ronand68/Ronand_Peralta_Electiva_2026_C1/tarea 1/DOC - Plantilla SRS ERS Norma IEEE-830 STD Wallys.odt

Especificación de requisitos de software

Proyecto: NIZAO

Revisión 1.0

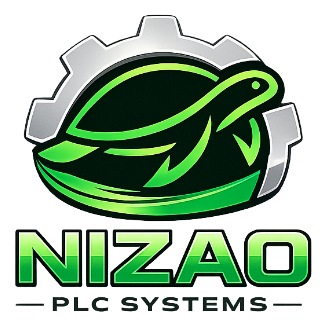
[picture p1: figure]

| | 01/2026

Instrucciones para el uso de este formato

Este formato es una plantilla tipo para documentos de requisitos del software.

Está basado y es conforme con el estándar IEEE Std 830-1998.

Las secciones que no se consideren aplicables al sistema descrito podrán de forma justificada indicarse como no aplicables (NA).

Notas:

Los textos en color azul son indicaciones que deben eliminarse y, en su caso, sustituirse por los contenidos descritos en cada apartado.

Los textos entre corchetes del tipo “[Inserte aquí el texto]” permiten la inclusión directa de texto con el color y estilo adecuado a la sección, al pulsar sobre ellos con el puntero del ratón.

Los títulos y subtítulos de cada apartado están definidos como estilos de MS Word, de forma que su numeración consecutiva se genera automáticamente según se trate de estilos “Titulo1, Titulo2 y Titulo3”.

La sangría de los textos dentro de cada apartado se genera automáticamente al pulsar Intro al final de la línea de título. (Estilos Normal indentado1, Normal indentado 2 y Normal indentado 3).

El índice del documento es una tabla de contenido que MS Word actualiza tomando como criterio los títulos del documento.

Una vez terminada su redacción debe indicarse a Word que actualice todo su contenido para reflejar el contenido definitivo.

De la plantilla de formato del documento © & Coloriuris http://www.qualitatis.org

# Ficha del documento

Fecha | Revisión | Autor | Verificado dep. calidad.
21/01/2026 | 1.0 | Wally Josep Hernandez Baez – Departamento de Proyectos | Pendiente

Documento validado por las partes en fecha: [Fecha]

Por el cliente | Por la empresa suministradora
Pendiente | Pendiente
Fdo. D./ Dña [Nombre] | Fdo. D./Dña [Nombre]

# Contenido

# Introducción

[Inserte aquí el texto]

## Propósito

Este documento define las especificaciones técnicas y los requisitos funcionales para el desarrollo del sistema [Nombre del Dron/Proyecto]. El objetivo es proporcionar una guía detallada para la integración de hardware, desarrollo de firmware y software de control de un sistema aéreo no tripulado (UAS) especializado en la inspección de infraestructuras críticas y monitoreo ambiental en entornos industriales.

## Alcance

[Inserte aquí el texto]

Capacidades Operativas

    - El desarrollo abarcará el diseño, integración y validación de las siguientes capacidades:
- Vuelo Multimodal: Implementación de modos de vuelo manual (asistido por sensores) y autónomo (mediante waypoints y misiones programadas vía Ground Control Station).
- Inspección Termográfica: Captura y transmisión en tiempo real de datos radiométricos para la identificación de anomalías térmicas en rangos de $[ -20°C, 550°C ]$.
- Monitoreo de Gases: Integración de un sistema de muestreo atmosférico capaz de detectar concentraciones de gases específicos (ej. $CH_4$, $CO$, $CO_2$) con georreferenciación de cada lectura.
- Navegación en Entornos Complejos: Sistema de evasión de obstáculos basado en sensores (ToF o Visión Computarizada) para garantizar la integridad en proximidad a estructuras metálicas.

### Desarrollo de Software y Control

- Interfaz de Control (GCS): Desarrollo o adaptación de una estación terrestre que permita la visualización simultánea de telemetría, video RGB/Térmico y niveles de gas.
- Algoritmos de Autonomía: Implementación de rutas de inspección optimizadas y protocolos de seguridad (RTL - Return to Launch) ante pérdida de enlace o batería crítica.
- Gestión de Datos: Creación de un log unificado que sincronice la posición GPS con las lecturas térmicas y químicas para su posterior análisis (Post-procesamiento).

## Personal involucrado

Nombre | Cristian Alejandro Candelario González[Inserte aquí el texto] | Wesley Antoine Rosario Pineda | Dayanna Yolanda Castillo Zacarias | José Alberto Canario Torres | Jhanquelis Silverio
Rol | = | = | = | = | =
Categoría profesional | Tecnico[Inserte aquí el texto] | Tecnico | Tecnico | Tecnico | Tecnico
Responsabilidades | [Inserte aquí el texto]
Información de contacto | [Inserte aquí el texto]
Aprobación | [Inserte aquí el texto]

## Definiciones, acrónimos y abreviaturas

### Definiciones Generales

- Carga Útil (Payload): Todo elemento transportado por el dron que no es necesario para el vuelo en sí, en este caso, el conjunto de cámaras térmicas y sensores de gas.
- GCS (Ground Control Station): Centro de mando terrestre (software y hardware) desde el cual se monitorea y controla el dron.
- Geofencing: Perímetro virtual definido por coordenadas GPS que limita el área de vuelo permitida por seguridad.
- Misión de Waypoints: Conjunto de coordenadas preprogramadas que el dron sigue de forma autónoma para completar una ruta de inspección.
- Radiometría: Capacidad de una cámara térmica para medir la temperatura absoluta de cada píxel en una imagen, no solo mostrar contrastes de calor.

[Inserte aquí el texto]

## Referencias

Referencia | Titulo | Ruta | Fecha | Autor
[Ref.] | [Título] | [Ruta] | [Fecha] | [Autor]

Relación completa de todos los documentos relacionados en la especificación de requisitos de software, identificando de cada documento el titulo, referencia (si procede), fecha y organización que lo proporciona.

## Resumen

[Inserte aquí el texto]

- Descripción del contenido del resto del documento
- Explicación de la organización del documento

# Descripción general

## Perspectiva del producto

NIZAO PLC es un PLC didáctico diseñado para prácticas de laboratorio. El producto no se usa como un equipo “aislado”, sino como el controlador central dentro de un puesto de entrenamiento donde los estudiantes cablean, programan y verifican maniobras típicas (arranque/parada, inversión de giro, enclavamientos, temporizaciones, conteos, secuencias y control básico de motores).

### Funcionalidad del producto

[Inserte aquí el texto]

Resumen de las funcionalidades principales que el producto debe realizar, sin entrar en información de detalle.

En ocasiones la información de esta sección puede tomarse de un documento de especificación del sistema de mayor nivel (ej. Requisitos del sistema).

Las funcionalidades deben estar organizadas de manera que el cliente o cualquier interlocutor pueda entenderlo perfectamente. Para ello se pueden utilizar métodos textuales o gráficos.

## Características de los usuarios

Tipo de usuario | [Inserte aquí el texto]
Formación | [Inserte aquí el texto]
Habilidades | [Inserte aquí el texto]
Actividades | [Inserte aquí el texto]

Descripción de los usuarios del producto, incluyendo nivel educacional, experiencia y experiencia técnica.

## Restricciones

[Inserte aquí el texto]

Descripción de aquellas limitaciones a tener en cuenta a la hora de diseñar y desarrollar el sistema, tales como el empleo de determinadas metodologías de desarrollo, lenguajes de programación, normas particulares, restricciones de hardware, de sistema operativo etc.

## Suposiciones y dependencias

[Inserte aquí el texto]

Descripción de aquellos factores que, si cambian, pueden afectar a los requisitos. Por ejemplo una asunción puede ser que determinado sistema operativo está disponible para el hardware requerido. De hecho, si el sistema operativo no estuviera disponible, la SRS debería modificarse.

## Evolución previsible del sistema

[Inserte aquí el texto]

Identificación de futuras mejoras al sistema, que podrán analizarse e implementarse en un futuro.

# Requisitos específicos

Esta es la sección más extensa y más importante del documento.

Debe contener una lista detallada y completa de los requisitos que debe cumplir el sistema a desarrollar. El nivel de detalle de los requisitos debe ser el suficiente para que el equipo de desarrollo pueda diseñar un sistema que satisfaga los requisitos y los encargados de las pruebas puedan determinar si éstos se satisfacen.

Los requisitos se dispondrán en forma de listas numeradas para su identificación, seguimiento, trazabilidad y validación (ej. RF 10, RF 10.1, RF 10.2,...).

Para cada requisito debe completarse la siguiente tabla:

Número de requisito | [Inserte aquí el texto]
Nombre de requisito | [Inserte aquí el texto]
Tipo | Requisito | Restricción
Fuente del requisito | [Inserte aquí el texto]
Prioridad del requisito | Alta/Esencial | Media/Deseado | Baja/ Opcional

y realizar la descripción del requisito

La distribución de los párrafos que forman este punto puede diferir del propuesto en esta plantilla, si las características del sistema aconsejan otra distribución para ofrecer mayor claridad en la exposición.

## Requisitos comunes de los interfaces

[Inserte aquí el texto]

Descripción detallada de todas las entradas y salidas del sistema de software.

### Interfaces de usuario

[Inserte aquí el texto]

Describir los requisitos del interfaz de usuario para el producto. Esto puede estar en la forma de descripciones del texto o pantallas del interfaz. Por ejemplo posiblemente el cliente ha especificado el estilo y los colores del producto. Describa exacto cómo el producto aparecerá a su usuario previsto.

### Interfaces de hardware

[Inserte aquí el texto]

Especificar las características lógicas para cada interfaz entre el producto y los componentes de hardware del sistema. Se incluirán características de configuración.

### Interfaces de software

[Inserte aquí el texto]

Indicar si hay que integrar el producto con otros productos de software.

Para cada producto de software debe especificarse lo siguiente:

- Descripción del producto software utilizado
- Propósito del interfaz
- Definición del interfaz: contiendo y formato

### Interfaces de comunicación

[Inserte aquí el texto]

Describir los requisitos del interfaces de comunicación si hay comunicaciones con otros sistemas y cuales son las protocolos de comunicación.

## Requisitos funcionales

[Inserte aquí el texto]

Definición de acciones fundamentales que debe realizar el software al recibir información, procesarla y producir resultados.

En ellas se incluye:

- Comprobación de validez de las entradas
- Secuencia exacta de operaciones
- Respuesta a situaciones anormales (desbordamientos, comunicaciones, recuperación de errores)
- Parámetros
- Generación de salidas
- Relaciones entre entradas y salidas (secuencias de entradas y salidas, formulas para la conversión de información)
- Especificación de los requisitos lógicos para la información que será almacenada en base de datos (tipo de información, requerido)

Las requisitos funcionales pueden ser divididos en sub-secciones.

### Requisito funcional 1

### Requisito funcional 2

### Requisito funcional 3

### Requisito funcional n

## Requisitos no funcionales

### Requisitos de rendimiento

[Inserte aquí el texto]

Especificación de los requisitos relacionados con la carga que se espera tenga que soportar el sistema. Por ejemplo, el número de terminales, el número esperado de usuarios simultáneamente conectados, número de transacciones por segundo que deberá soportar el sistema, etc.

Todos estos requisitos deben ser mesurables. Por ejemplo, indicando “el 95% de las transacciones deben realizarse en menos de 1 segundo”, en lugar de “los operadores no deben esperar a que se complete la transacción”.

### Seguridad

[Inserte aquí el texto]

Especificación de elementos que protegerán al software de accesos, usos y sabotajes maliciosos, así como de modificaciones o destrucciones maliciosas o accidentales. Los requisitos pueden especificar:

- Empleo de técnicas criptográficas.
- Registro de ficheros con “logs” de actividad.
- Asignación de determinadas funcionalidades a determinados módulos.
- Restricciones de comunicación entre determinados módulos.
- Comprobaciones de integridad de información crítica.

### Fiabilidad

[Inserte aquí el texto]

Especificación de los factores de fiabilidad necesaria del sistema. Esto se expresa generalmente como el tiempo entre los incidentes permisibles, o el total de incidentes permisible.

### Disponibilidad

[Inserte aquí el texto]

Especificación de los factores de disponibilidad final exigidos al sistema. Normalmente expresados en % de tiempo en los que el software tiene que mostrar disponibilidad.

### Mantenibilidad

[Inserte aquí el texto]

Identificación del tipo de mantenimiento necesario del sistema.

Especificación de quien debe realizar las tareas de mantenimiento, por ejemplo usuarios, o un desarrollador.

Especificación de cuando debe realizarse las tareas de mantenimiento. Por ejemplo, generación de estadísticas de acceso semanales y mensuales.

### Portabilidad

[Inserte aquí el texto]

Especificación de atributos que debe presentar el software para facilitar su traslado a otras plataformas u entornos. Pueden incluirse:

- Porcentaje de componentes dependientes del servidor.
- Porcentaje de código dependiente del servidor.
- Uso de un determinado lenguaje por su portabilidad.
- Uso de un determinado compilador o plataforma de desarrollo.
- Uso de un determinado sistema operativo.

## Otros requisitos

[Inserte aquí el texto]

Cualquier otro requisito que no encaje en ninguna de las secciones anteriores.

Por ejemplo:

Requisitos culturales y políticos

Requisitos Legales

# Apéndices

[Inserte aquí el texto]

Pueden contener todo tipo de información relevante para la SRS pero que, propiamente, no forme parte de la SRS.

Modelo de ingeniería [Nombre documento] 0.3 Pág. 3

Descripción de requisitos del sofware

PLC FOR UNI Especificación de requisitos de software Rev. [99.99] Pág. 5

NIZAO Especificación de requisitos de software Rev. [99.99] Pág. 5
