ronand68/Ronand_Peralta_Electiva_2026_C1/tarea 1/ERS_NIZAO_PLC_IEEE830.docx

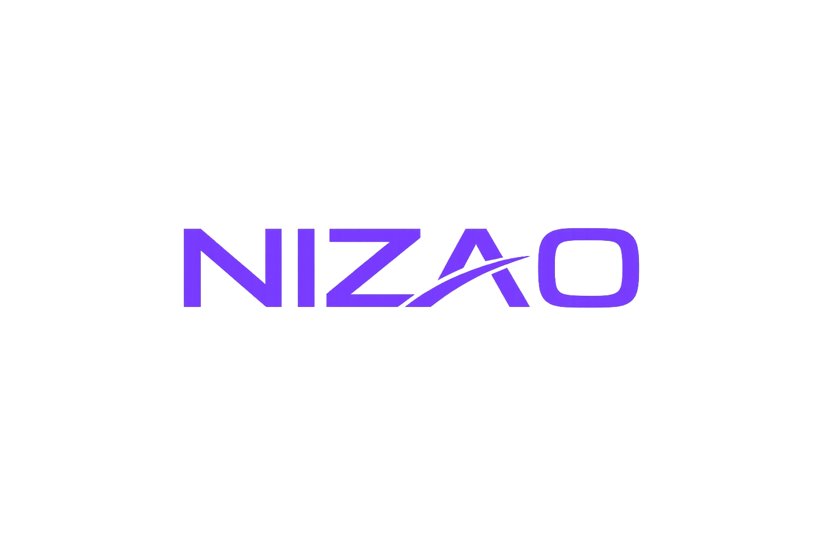
[picture p2: figure]

Especificación de requisitos de software

Proyecto: NIZAO PLC

Revisión 1.0

| | 04/2026

Instrucciones para el uso de este formato

Este formato es una plantilla tipo para documentos de requisitos del software.

Está basado y es conforme con el estándar IEEE Std 830-1998.

Las secciones que no se consideren aplicables al sistema descrito podrán de forma justificada indicarse como no aplicables (NA).

Notas:

Los textos en color azul son indicaciones que deben eliminarse y, en su caso, sustituirse por los contenidos descritos en cada apartado.

Los textos entre corchetes del tipo “[Inserte aquí el texto]” permiten la inclusión directa de texto con el color y estilo adecuado a la sección, al pulsar sobre ellos con el puntero del ratón.

Los títulos y subtítulos de cada apartado están definidos como estilos de MS Word, de forma que su numeración consecutiva se genera automáticamente según se trate de estilos “Titulo1, Titulo2 y Titulo3”.

La sangría de los textos dentro de cada apartado se genera automáticamente al pulsar Intro al final de la línea de título. (Estilos Normal indentado1, Normal indentado 2 y Normal indentado 3).

El índice del documento es una tabla de contenido que MS Word actualiza tomando como criterio los títulos del documento.

Una vez terminada su redacción debe indicarse a Word que actualice todo su contenido para reflejar el contenido definitivo.

De la plantilla de formato del documento © & Coloriuris http://www.qualitatis.org

# Ficha del documento

Fecha | Revisión | Autor | Verificado dep. calidad.
23/04/2026 | 1.0 | Ronand Peralta – Proyecto NIZAO PLC | Pendiente

Documento validado por las partes en fecha: [Fecha]

Por el cliente | Por la empresa suministradora
Pendiente | Pendiente
Fdo. D./Dña. Representante del cliente | Fdo. D./Dña. Representante del equipo NIZAO

# Contenido

# 2 Introducción

La presente Especificación de Requisitos de Software (ERS) describe las necesidades funcionales y no funcionales del proyecto NIZAO PLC, un controlador lógico programable didáctico e industrial basado en el microcontrolador ESP32-S3-WROOM-1. El documento se elabora con el fin de conservar la estructura formal de la plantilla IEEE 830 y servir como guía de desarrollo, integración y validación del sistema.

## 2.1 Propósito

Este documento define las especificaciones técnicas y los requisitos funcionales del sistema NIZAO PLC. Su propósito es establecer una base clara para el diseño de hardware y firmware, la implementación de la HMI, la integración de comunicaciones industriales y la posterior verificación del comportamiento del controlador.

## 2.2 Alcance

El alcance de esta ERS comprende el firmware principal del PLC, la interfaz HMI local, los drivers de entradas y salidas, la conectividad industrial y los servicios de configuración. El sistema está orientado a prácticas de laboratorio, prototipado, validación de arquitectura PLC/HMI y futuras pruebas con PCB propio.

Capacidades Operativas

    - El desarrollo abarcará el diseño, integración y validación de las siguientes capacidades:
- Adquisición de entradas digitales: lectura de señales de campo NPN y PNP con actualización cíclica y representación en HMI.
- Control de salidas digitales: accionamiento de salidas NPN, PNP y de relé con visualización de estado y operación segura.
- Adquisición analógica: lectura de variables a través de ADC externo para soportar señales de proceso y sensórica complementaria.
- Generación analógica: control de salidas 4-20 mA y 0-10 V para instrumentación y actuadores compatibles.

### 2.2.1 Monitorización de energía: lectura de variables como voltaje, corriente, potencia y frecuencia mediante el lector de energía.

- Interfaz HMI: navegación en pantalla táctil LCD con menús de Inicio, Estados, Control, Configuración, Comunicación, Alarmas, Mantenimiento y Sistema.
- Comunicación industrial: integración de Modbus, MQTT, OpenPLC y 4Diac mediante una arquitectura modular y escalable.
- Configuración y servicio: configuración local y remota por web server, Wi‑Fi, Bluetooth BLE, USB device y almacenamiento en SD.

Trazabilidad y mantenimiento: registro de parámetros, conservación de configuración y posibilidad de ampliación del firmware por componentes.

Nombre | Ronand Peralta | Equipo de firmware NIZAO | Equipo HMI y documentación | Equipo de integración | Control de calidad
Rol | Líder del proyecto | Desarrollo embebido | Diseño de interfaz | Comunicaciones y servicios | Pruebas y documentación
Categoría profesional | Técnico / Estudiante | Técnico | Técnico | Técnico | Técnico
Responsabilidades | Definir requisitos, arquitectura, integración y validación general del PLC NIZAO. | Implementar firmware base, drivers y servicios del sistema. | Definir pantallas, navegación HMI y lineamientos de experiencia de usuario. | Integrar Modbus, MQTT, web config, Wi‑Fi y BLE. | Ejecutar pruebas funcionales y mantener la ERS actualizada.
Información de contacto | Pendiente de completar | Pendiente | Pendiente | Pendiente | Pendiente
Aprobación | Pendiente de aprobación | Pendiente | Pendiente | Pendiente | Pendiente

## 2.4 Definiciones, acrónimos y abreviaturas

### 2.4.1 Definiciones Generales

- PLC (Programmable Logic Controller): equipo programable destinado a la adquisición de señales de entrada, procesamiento lógico y control de salidas en procesos de automatización.
- HMI (Human Machine Interface): interfaz hombre-máquina que permite al usuario visualizar estados, alarmas, parámetros y acciones de control sobre el PLC.
- ESP-IDF: framework oficial de Espressif para el desarrollo de firmware sobre ESP32-S3, utilizado como base del proyecto NIZAO PLC.
- LVGL: librería gráfica utilizada para construir la interfaz visual de la HMI y la navegación de pantallas del sistema.
- Modbus / MQTT / OpenPLC / 4Diac: protocolos y capas de interoperabilidad previstas para comunicación industrial, supervisión y lógica distribuida.

Abreviaturas principales: DI (Digital Input), DO (Digital Output), AI (Analog Input), AO (Analog Output), BLE (Bluetooth Low Energy), HMI (Human Machine Interface), ERS (Especificación de Requisitos de Software).

## 2.5 Referencias

Referencia | Titulo | Ruta | Fecha | Autor
REF-01 | ESP-IDF Programming Guide v6.0 | https://docs.espressif.com/projects/esp-idf/en/v6.0/ | 2026 | Espressif Systems
REF-02 | LVGL Documentation | https://docs.lvgl.io/ | 2026 | LVGL Project
REF-03 | IEEE Std 830-1998 | Especificación de requisitos de software | 1998 | IEEE
REF-04 | Planificación de la Pantalla - Imágenes | Documento interno del proyecto | 2026 | Proyecto NIZAO
REF-05 | plc_firmware.zip | Repositorio base del firmware del PLC NIZAO | 2026 | Proyecto NIZAO

Relación completa de todos los documentos relacionados en la especificación de requisitos de software, identificando de cada documento el titulo, referencia (si procede), fecha y organización que lo proporciona.

## 2.6 Resumen

El documento se organiza en: introducción, descripción general, requisitos específicos y apéndices. Cada sección conserva la estructura de la plantilla y se ha completado con la información correspondiente al proyecto NIZAO PLC.

- Descripción del contenido del resto del documento: la sección 2 resume el producto, la sección 3 establece requisitos verificables y la sección 4 reúne información de apoyo, mapas y anexos.
- Explicación de la organización del documento: la ERS sirve de referencia para el equipo de desarrollo, pruebas e integración, y deberá actualizarse conforme avance el hardware definitivo.

# 3 Descripción general

## 3.1 Perspectiva del producto

## 3.2 NIZAO PLC es un PLC didáctico y de desarrollo diseñado para prácticas de laboratorio, demostración tecnológica y futura validación sobre PCB propio. El producto actúa como controlador central con arquitectura modular, separando BSP, drivers, servicios, comunicaciones, núcleo PLC y HMI.

### 3.2.1 Funcionalidad del producto

El producto debe realizar, de manera resumida, las siguientes funciones: lectura y monitoreo de entradas digitales; control de salidas digitales; lectura de entradas analógicas y energía; generación de salidas analógicas; presentación de estados y alarmas en una HMI táctil; configuración local y remota; comunicación por Modbus y MQTT; y distribución de un snapshot de E/S hacia OpenPLC y 4Diac.

## 3.3 Características de los usuarios

Tipo de usuario | Estudiantes de automatización, docentes, técnicos de laboratorio e integradores.
Formación | Formación técnica en electrónica, mecatrónica, electricidad o automatización industrial.
Habilidades | Cableado básico de E/S, interpretación de estados, configuración de parámetros y uso de interfaces HMI.
Actividades | Configurar el equipo, monitorear variables, ejecutar prácticas, validar señales y realizar pruebas funcionales.

Descripción de los usuarios del producto, incluyendo nivel educacional, experiencia y experiencia técnica.

## 3.4 Restricciones

El sistema debe ejecutarse sobre el microcontrolador ESP32-S3-WROOM-1 y desarrollarse en ESP-IDF. La HMI debe adecuarse a una pantalla compacta de aproximadamente 320 px de ancho. La arquitectura se desarrollará primero en software, debido a que el PCB definitivo aún no se encuentra disponible. El USB deberá usarse en modo dispositivo y la configuración deberá contemplar web server, Wi‑Fi y Bluetooth.

Descripción de aquellas limitaciones a tener en cuenta a la hora de diseñar y desarrollar el sistema, tales como el empleo de determinadas metodologías de desarrollo, lenguajes de programación, normas particulares, restricciones de hardware, de sistema operativo etc.

## 3.5 Suposiciones y dependencias

Se asume la disponibilidad de una pantalla LCD táctil compatible, drivers escalables para los distintos periféricos y la futura definición de los pines finales del PCB. También se asume la continuidad de la arquitectura modular actual y la posibilidad de integrar servicios como Modbus, MQTT, LVGL, TinyUSB y manejo de SD sin rediseñar la base del firmware.

Descripción de aquellos factores que, si cambian, pueden afectar a los requisitos. Por ejemplo una asunción puede ser que determinado sistema operativo está disponible para el hardware requerido. De hecho, si el sistema operativo no estuviera disponible, la SRS debería modificarse.

## 3.6 Evolución previsible del sistema

Como evolución prevista se contemplan: integración del hardware final del PCB; paso de drivers mock/skeleton a drivers reales; ampliación del mapa Modbus; incorporación de registro de datos en SD; actualización OTA; refuerzo de seguridad y autenticación; y madurez del bridge con OpenPLC y 4Diac.

Identificación de futuras mejoras al sistema, que podrán analizarse e implementarse en un futuro.

# 4 Requisitos específicos

Esta es la sección más extensa y más importante del documento.

Debe contener una lista detallada y completa de los requisitos que debe cumplir el sistema a desarrollar. El nivel de detalle de los requisitos debe ser el suficiente para que el equipo de desarrollo pueda diseñar un sistema que satisfaga los requisitos y los encargados de las pruebas puedan determinar si éstos se satisfacen.

Los requisitos se dispondrán en forma de listas numeradas para su identificación, seguimiento, trazabilidad y validación (ej. RF 10, RF 10.1, RF 10.2,...).

Para cada requisito debe completarse la siguiente tabla:

Número de requisito | RF-03
Nombre de requisito | Comunicaciones industriales
Tipo | Requisito | Requisito
Fuente del requisito | Necesidad del proyecto
Prioridad del requisito | Alta/Esencial | Alta/Esencial | Alta/Esencial

y realizar la descripción del requisito

La distribución de los párrafos que forman este punto puede diferir del propuesto en esta plantilla, si las características del sistema aconsejan otra distribución para ofrecer mayor claridad en la exposición.

## 4.1 Requisitos comunes de los interfaces

El sistema de software debe contemplar interfaces para usuario, hardware, software y comunicaciones. Entre sus principales E/S se consideran entradas digitales NPN/PNP, salidas digitales NPN/PNP/relé, entradas analógicas por ADC externo, salidas analógicas 4-20 mA y 0-10 V, lectura de energía, pantalla LCD táctil, USB device, SD, Wi‑Fi, BLE y buses de comunicación industriales.

Descripción detallada de todas las entradas y salidas del sistema de software.

### 4.1.1 Interfaces de usuario

La interfaz de usuario será una HMI con estilo moderno e industrial, menú horizontal compacto y navegación por secciones: Inicio, Estados, Control, Configuración, Comunicación, Alarmas, Mantenimiento y Sistema. La tipografía será sans serif, con buena legibilidad y uso coherente de color para estados, foco y alarmas.

Describir los requisitos del interfaz de usuario para el producto. Esto puede estar en la forma de descripciones del texto o pantallas del interfaz. Por ejemplo posiblemente el cliente ha especificado el estilo y los colores del producto. Describa exacto cómo el producto aparecerá a su usuario previsto.

### 4.1.2 Interfaces de hardware

Las interfaces de hardware del producto incluyen el ESP32-S3-WROOM-1, la pantalla LCD, el panel táctil, el ADC externo, el lector de energía, entradas/salidas digitales, salidas analógicas, puerto USB en modo dispositivo y almacenamiento SD. La configuración lógica deberá abstraerse mediante drivers específicos y un BSP central.

Especificar las características lógicas para cada interfaz entre el producto y los componentes de hardware del sistema. Se incluirán características de configuración.

### Interfaces de software

El software deberá integrarse con ESP-IDF como plataforma base, LVGL para la HMI, TinyUSB para USB device, un stack web para configuración, soporte de Wi‑Fi/BLE, servicios de Modbus y MQTT, y bridges internos para OpenPLC y 4Diac.

### 4.1.3 Interfaces de comunicación

Las interfaces de comunicación del sistema incluyen Modbus, MQTT, Wi‑Fi, BLE, USB device y servidor web de configuración. El protocolo Modbus deberá disponer de una definición explícita de registros (coils, discrete inputs, input registers y holding registers). MQTT deberá contemplar publicación de estados y recepción de comandos. El acceso de configuración deberá poder realizarse desde la web y apoyarse en conectividad Wi‑Fi y Bluetooth.

Describir los requisitos del interfaces de comunicación si hay comunicaciones con otros sistemas y cuales son las protocolos de comunicación.

## 4.2 Requisitos funcionales

El software deberá validar entradas, ejecutar secuencias de inicialización, operar un ciclo periódico de actualización, detectar fallos de comunicación y producir salidas coherentes tanto para la HMI como para servicios de comunicación. Los requisitos funcionales principales se resumen a continuación.

### 4.2.1 Requisito funcional 1: Gestión de entradas y salidas

El sistema deberá inicializar y gestionar entradas y salidas digitales, entradas analógicas, salidas analógicas y lectura de energía mediante drivers desacoplados del hardware final.

La HMI deberá permitir visualizar estados, alarmas y valores de proceso, así como acceder a pantallas de configuración de red, sistema y comunicación con una navegación clara y consistente.

El sistema deberá intercambiar información con redes y herramientas externas a través de Modbus, MQTT, servidor web, Wi‑Fi y BLE, garantizando trazabilidad y consistencia de los datos.

El firmware deberá contar con un plc_core mínimo que construya snapshots de E/S y los distribuya a los bridges de OpenPLC y 4Diac para facilitar la interoperabilidad y evolución futura.

### 4.2.2 Requisito funcional 2: HMI y configuración

### 4.2.3 Requisito funcional 3: Comunicación industrial y servicios

### 4.2.4 Requisito funcional 4: Núcleo PLC e interoperabilidad

## 4.3 Requisitos no funcionales

### 4.3.1 Requisitos de rendimiento

El sistema deberá actualizar el estado de las E/S en ciclos periódicos y reflejar cambios en menos de 500 ms en la HMI local. El arranque base del sistema no deberá exceder 5 s en condiciones nominales. Las operaciones de navegación HMI deberán percibirse fluidas y las publicaciones MQTT/actualizaciones de registros deberán ejecutarse dentro del ciclo previsto del servicio correspondiente.

Especificación de los requisitos relacionados con la carga que se espera tenga que soportar el sistema. Por ejemplo, el número de terminales, el número esperado de usuarios simultáneamente conectados, número de transacciones por segundo que deberá soportar el sistema, etc.

Todos estos requisitos deben ser mesurables. Por ejemplo, indicando “el 95% de las transacciones deben realizarse en menos de 1 segundo”, en lugar de “los operadores no deben esperar a que se complete la transacción”.

### 4.3.2 Seguridad

El software deberá proteger la configuración del equipo mediante mecanismos de autenticación básica, validación de datos y almacenamiento controlado. Se recomienda usar cifrado cuando la conectividad de red lo requiera, generar logs de actividad y separar los privilegios de operación, mantenimiento y configuración.

Especificación de elementos que protegerán al software de accesos, usos y sabotajes maliciosos, así como de modificaciones o destrucciones maliciosas o accidentales. Los requisitos pueden especificar:

- Empleo de técnicas criptográficas.
- Registro de ficheros con “logs” de actividad.
- Asignación de determinadas funcionalidades a determinados módulos.
- Restricciones de comunicación entre determinados módulos.
- Comprobaciones de integridad de información crítica.

### 4.3.3 Fiabilidad

El sistema deberá mantener una operación estable ante fallos transitorios de comunicación o ausencia temporal de algunos periféricos. Los servicios deberán devolver códigos de error explícitos y el firmware deberá poder reiniciar módulos de forma controlada sin comprometer el resto del sistema.

Especificación de los factores de fiabilidad necesaria del sistema. Esto se expresa generalmente como el tiempo entre los incidentes permisibles, o el total de incidentes permisible.

### 4.3.4 Disponibilidad

La disponibilidad objetivo del software en operación de laboratorio será alta, con capacidad de reinicio limpio y recuperación tras fallas. En revisiones futuras con hardware final se definirá una meta cuantitativa de disponibilidad, manteniendo el objetivo de servicio continuo durante las sesiones de práctica y validación.

Especificación de los factores de disponibilidad final exigidos al sistema. Normalmente expresados en % de tiempo en los que el software tiene que mostrar disponibilidad.

### 4.3.5 Mantenibilidad

El proyecto debe mantenerse con arquitectura modular por componentes, documentación de APIs, separación entre drivers y lógica, y facilidad de sustitución de implementaciones. El mantenimiento podrá ser realizado por el desarrollador principal o por futuros integrantes del equipo, apoyándose en documentación técnica y pruebas incrementales.

Identificación del tipo de mantenimiento necesario del sistema.

Especificación de quien debe realizar las tareas de mantenimiento, por ejemplo usuarios, o un desarrollador.

Especificación de cuando debe realizarse las tareas de mantenimiento. Por ejemplo, generación de estadísticas de acceso semanales y mensuales.

### 4.3.6 Portabilidad

El software deberá ser portable dentro del ecosistema ESP32 siempre que los periféricos equivalentes estén disponibles. Se priorizará lenguaje C, uso de ESP-IDF y encapsulamiento por capas para facilitar la migración entre revisiones de hardware o variantes del producto.

Especificación de atributos que debe presentar el software para facilitar su traslado a otras plataformas u entornos. Pueden incluirse:

- Porcentaje de componentes dependientes del servidor.
- Porcentaje de código dependiente del servidor.
- Uso de un determinado lenguaje por su portabilidad.
- Uso de un determinado compilador o plataforma de desarrollo.
- Uso de un determinado sistema operativo.

## 4.4 Otros requisitos

Como otros requisitos se consideran: coherencia estética de la interfaz HMI, adecuación a fines didácticos, trazabilidad de los cambios de configuración, definición documentada del mapa Modbus y capacidad de expansión del sistema hacia web server, almacenamiento local, monitoreo remoto y actualizaciones futuras.

Cualquier otro requisito que no encaje en ninguna de las secciones anteriores.

Por ejemplo:

Árbol base del proyecto: main, components/bsp, components/common, components/drivers, components/comms, components/services y components/plc_core.

Entradas y salidas previstas: entradas digitales NPN/PNP, salidas digitales NPN/PNP/relé, AI por ADC externo, AO 4-20 mA, AO 0-10 V, LCD táctil, SD y USB device.

Mapa Modbus preliminar: coils para salidas digitales, discrete inputs para entradas digitales, input registers para variables medidas y holding registers para consignas y parámetros de configuración.

Estado del hardware: PCB definitivo pendiente de validación. La arquitectura de firmware se desarrolla primero en software para acelerar la integración posterior del hardware real.

Requisitos culturales y políticos

Requisitos Legales

# 5 Apéndices

Los apéndices podrán contener el árbol del proyecto plc_firmware, el mapa preliminar de entradas y salidas, tablas de registros Modbus, vistas de HMI, referencias al firmware base y cualquier otro material de soporte relevante para la implementación del sistema.

Pueden contener todo tipo de información relevante para la SRS pero que, propiamente, no forme parte de la SRS.

Descripción de requisitos del software

Descripción de requisitos del sofware

NIZAO PLC Especificación de requisitos de software Rev. 1.0 Pág.
