ronand68/Ronand_Peralta_Electiva_2026_C1/tarea 3/CircuitosBloque/IN_PNP_NPN.docx

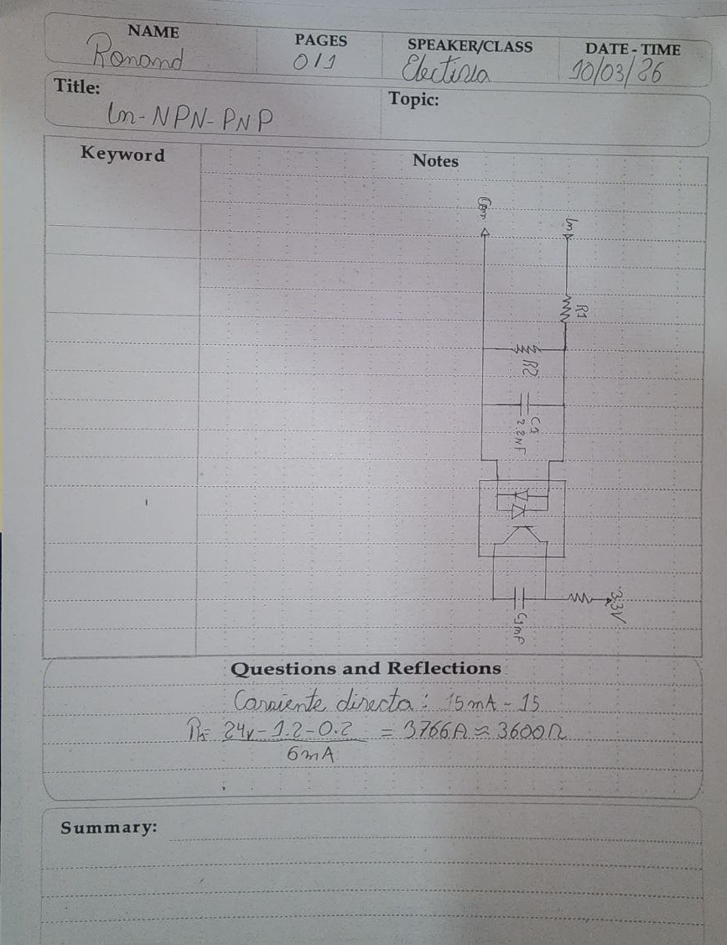
[picture p4: figure]
