ronand68/Ronand_Peralta_Electiva_2026_C1/tarea 3/Esquema/Esquema de Bloques.docx

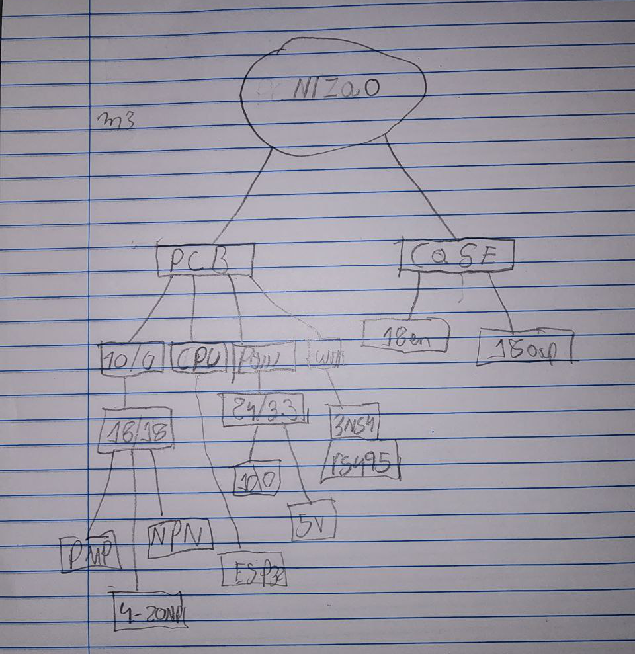
[picture p5: figure]
