ronand68/Ronand_Peralta_Electiva_2026_C1/tarea 1/resumen MBSE.pdf

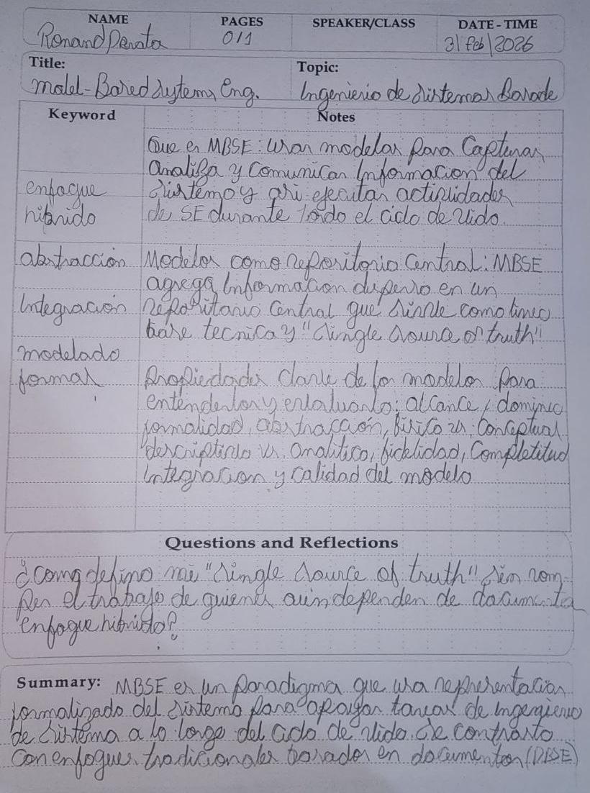
[picture p6: page 1]
