ronand68/Ronand_Peralta_Electiva_2026_C1/NIZAO/NIZAO_3D.FCStd

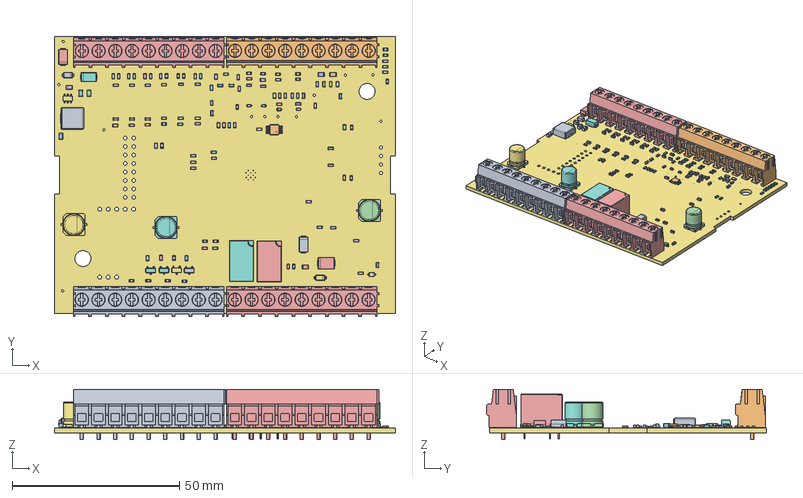
[picture p7: CAD file, 2026-04-01]
NIZAO/NIZAO_3D.FCStd
102.0 x 83.7 x 15.0 mm
R_0603_1608Metric
R_0603_1608Metric001
R_0805_2012Metric
R_0603_1608Metric002
R_0603_1608Metric003
R_0603_1608Metric004
LED_0603_1608Metric
R_0603_1608Metric005
R_0603_1608Metric006
TSSOP-10_3x3mm_P0.5mm
R_0603_1608Metric007
R_0603_1608Metric008
R_0603_1608Metric009
R_0603_1608Metric010
SOT-23-3
R_0603_1608Metric011
TerminalBlock_Phoenix_PT-1,5-9-5.0-H_1x09_P5.00mm_Horizontal
R_0805_2012Metric001
R_0603_1608Metric012
CP_Elec_6.3x7.7
C_0603_1608Metric
C_0603_1608Metric001
TSOT-23-6
R_0603_1608Metric013
R_0603_1608Metric014
R_0603_1608Metric015
C_0603_1608Metric002
R_0603_1608Metric016
R_0603_1608Metric017
C_0603_1608Metric003
C_0603_1608Metric004
D_SMA
LED_0603_1608Metric001
C_0603_1608Metric005
C_0603_1608Metric006
C_0603_1608Metric007
R_0805_2012Metric002
R_0603_1608Metric018
C_0603_1608Metric008
SOT-23-004
R_0603_1608Metric019
R_0603_1608Metric020
C_0603_1608Metric009
D_SOD-523
R_0603_1608Metric021
C_0603_1608Metric010
R_0603_1608Metric022
C_0603_1608Metric011
R_0603_1608Metric023
R_0603_1608Metric024
R_0603_1608Metric025
C_0603_1608Metric012
R_0603_1608Metric026
R_0603_1608Metric027
D_SOD-323
C_0805_2012Metric
R_0603_1608Metric028
R_0603_1608Metric029
D_SOD-524
C_0603_1608Metric013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
