ronand68/Ronand_Peralta_Electiva_2026_C1/tarea 2/Freecad/Base Del Case Plástico.V1.01.FCStd

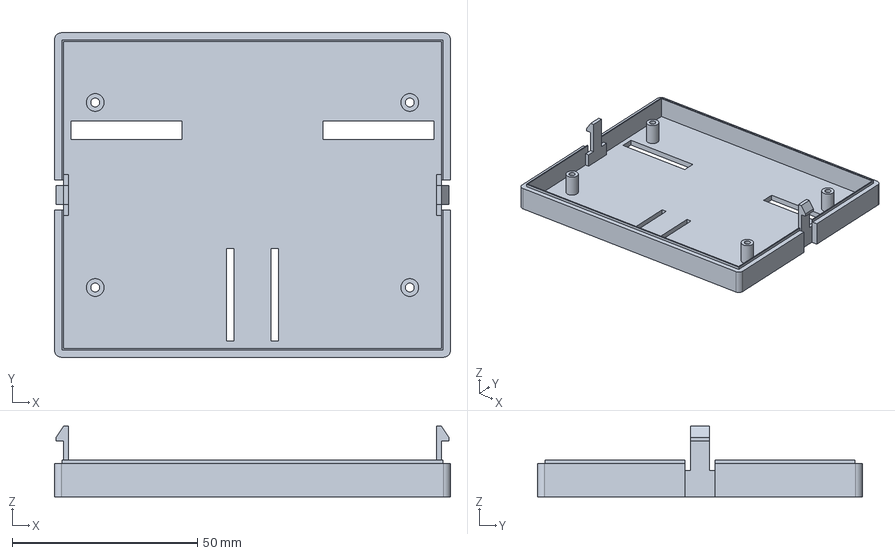
[picture p8: CAD file, 2026-04-20]
tarea 2/Freecad/Base Del Case Plástico.V1.01.FCStd
107.0 x 87.7 x 19.1 mm
