ronand68/Ronand_Peralta_Electiva_2026_C1/tarea 2/SoidEdge/Tapa Del Case Plastico.stp

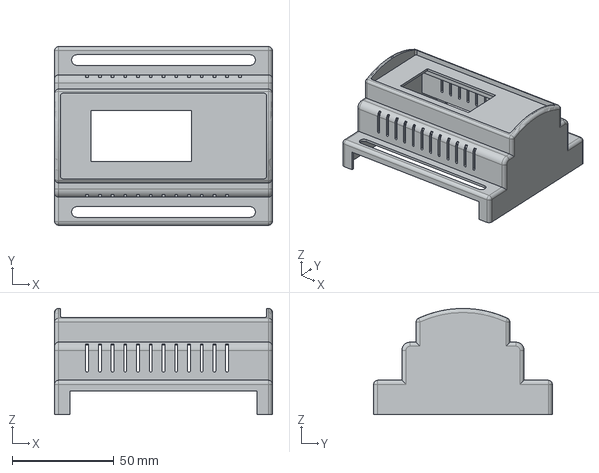
[picture p9: CAD file, 2026-03-12]
tarea 2/SoidEdge/Tapa Del Case Plastico.stp
107.0 x 87.7 x 52.1 mm
