ronand68/Ronand_Peralta_Electiva_2026_C1/tarea 4/Pantalla LCD.FCStd

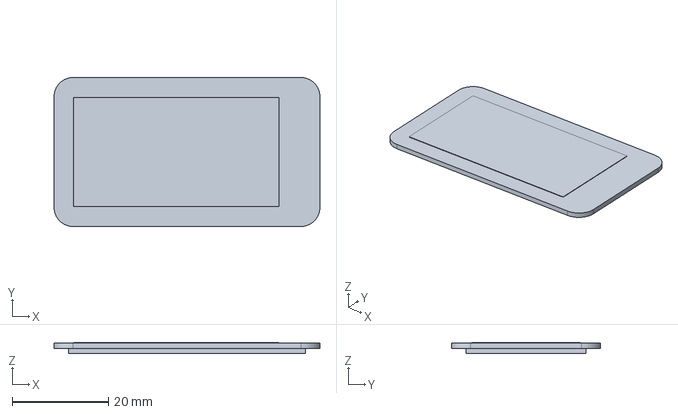
[picture p10: CAD file, 2026-04-01]
tarea 4/Pantalla LCD.FCStd
55.3 x 31.0 x 2.21 mm
