ronand68/Ronand_Peralta_Electiva_2026_C1/tarea 2/Freecad/Tapa Del Case Plástico.V1.01.FCStd

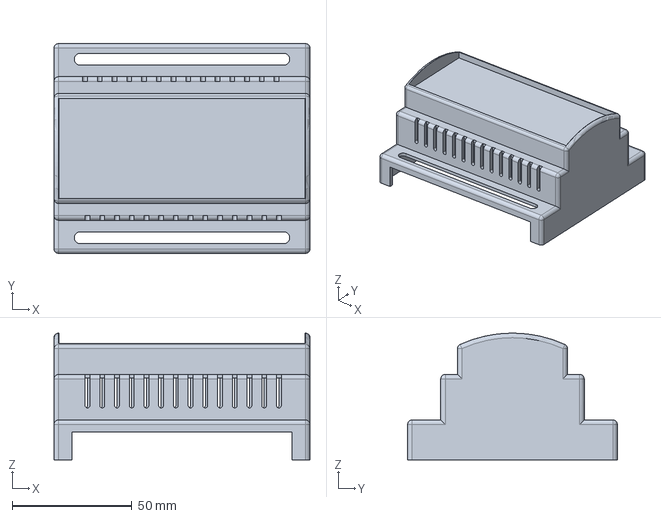
[picture p12: CAD file, 2026-04-20]
tarea 2/Freecad/Tapa Del Case Plástico.V1.01.FCStd
107.0 x 87.7 x 53.0 mm
