ronand68/Ronand_Peralta_Electiva_2026_C1/tarea 4/RS-485.FCStd

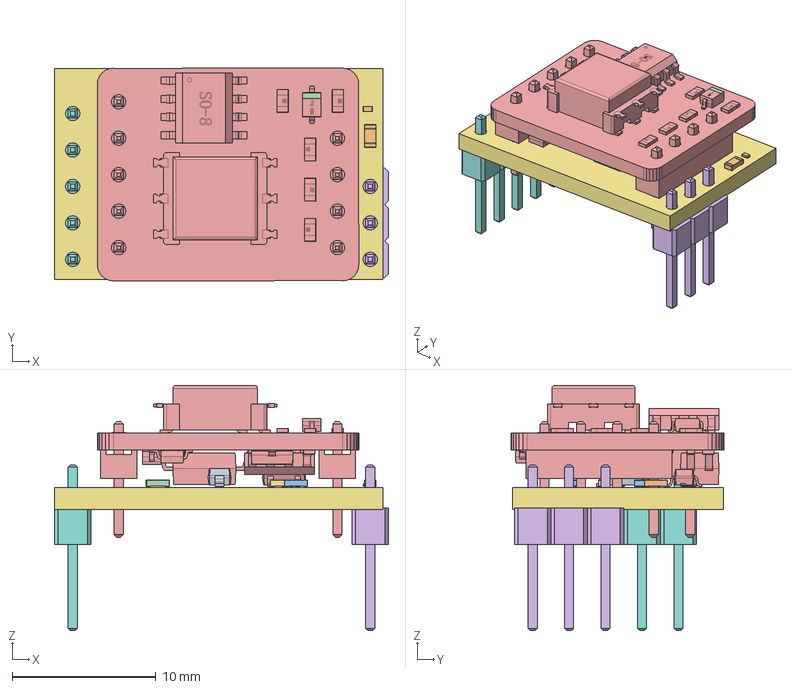
[picture p13: CAD file, 2026-04-01]
tarea 4/RS-485.FCStd
23.3 x 14.8 x 17.1 mm
D_SOD-123
LED_0201_0603Metric
R_0603_1608Metric
R_0603_1608Metric001
SOT-23
R_0603_1608Metric002
R_0603_1608Metric003
PinHeader_1x05_P2.54mm_Vertical
R_0603_1608Metric004
R_0603_1608Metric005
R_0603_1608Metric006
PinHeader_1x03_P2.54mm_Vertical
RS CON PROT_PCB
