ronand68/Ronand_Peralta_Electiva_2026_C1/tarea 2/SoidEdge/Tapa Del Case Plastico_F.dxf

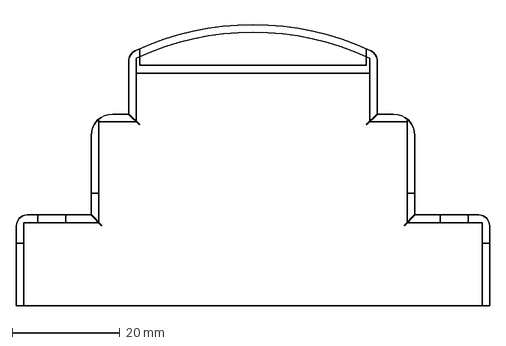
[picture p14: CAD file, 2026-03-10]
tarea 2/SoidEdge/Tapa Del Case Plastico_F.dxf
87.7 x 53.7 mm
