ronand68/Ronand_Peralta_Electiva_2026_C1/tarea 2/SoidEdge/Base Del Case Plastico_F.dxf

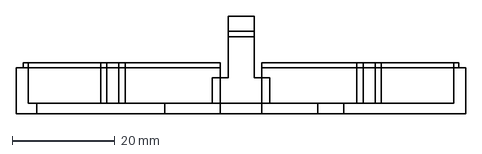
[picture p15: CAD file, 2026-03-10]
tarea 2/SoidEdge/Base Del Case Plastico_F.dxf
87.7 x 19.1 mm
