ronand68/Ronand_Peralta_Electiva_2026_C1/tarea 2/Freecad/Base Del Case Plástico.FCStd

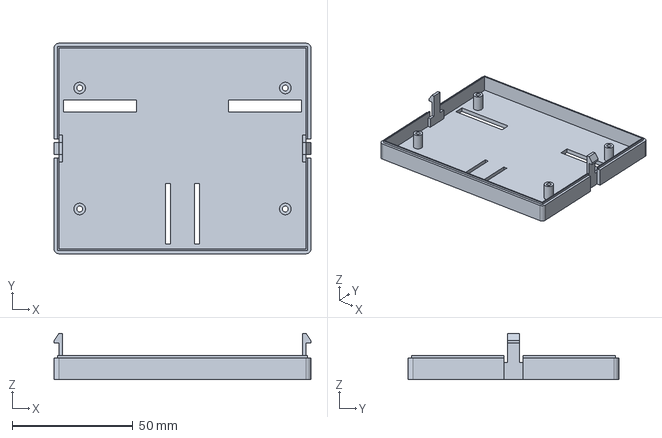
[picture p16: CAD file, 2026-03-02, an earlier design]
tarea 2/Freecad/Base Del Case Plástico.FCStd
106.2 x 87.0 x 19.1 mm
