ronand68/Ronand_Peralta_Electiva_2026_C1/tarea 2/Freecad/Tapa Del Case Plástico.FCStd

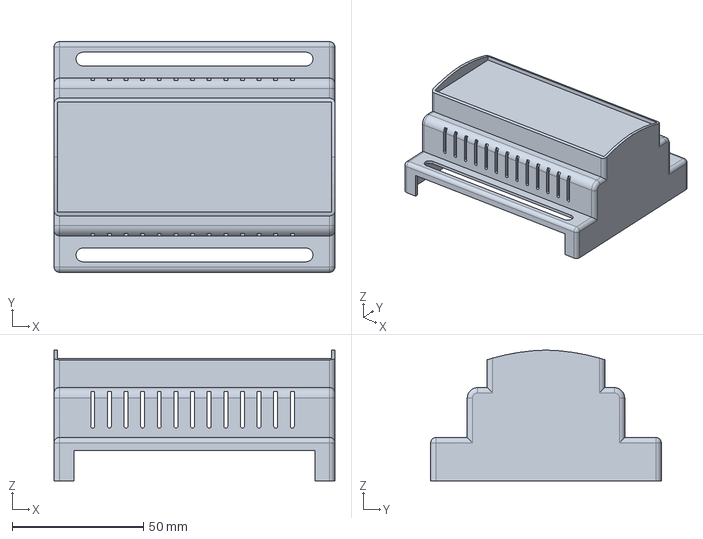
[picture p17: CAD file, 2026-03-02, an earlier design]
tarea 2/Freecad/Tapa Del Case Plástico.FCStd
107.0 x 87.8 x 49.8 mm
