ronand68/Ronand_Peralta_Electiva_2026_C1/(list of files, cad)

Other CAD files:
tarea 4/ASSEMBLY/NIZAO_Assembly.V1.1.FCStd
NIZAO/NIZAO.step
tarea 2/SoidEdge/Base Del Case Plastico.stp
tarea 4/PLC4UNI_MEZZANINE_PCB1/PLC4UNI_MEZZANINE_PCB1.FCStd
NIZAO/NIZAO.FCStd
tarea 2/SoidEdge/Base Del Case Plastico.FCStd
tarea 2/SoidEdge/Base Del Case Plastico.dxf
tarea 2/SoidEdge/Tapa Del Case Plastico.FCStd
tarea 2/SoidEdge/Tapa Del Case Plastico.dxf
