ronand68/Ronand_Peralta_Electiva_2026_C1/NIZAO/NIZAO.kicad_pcb

## KiCad design NIZAO/NIZAO.kicad_pcb (2026-04-16)

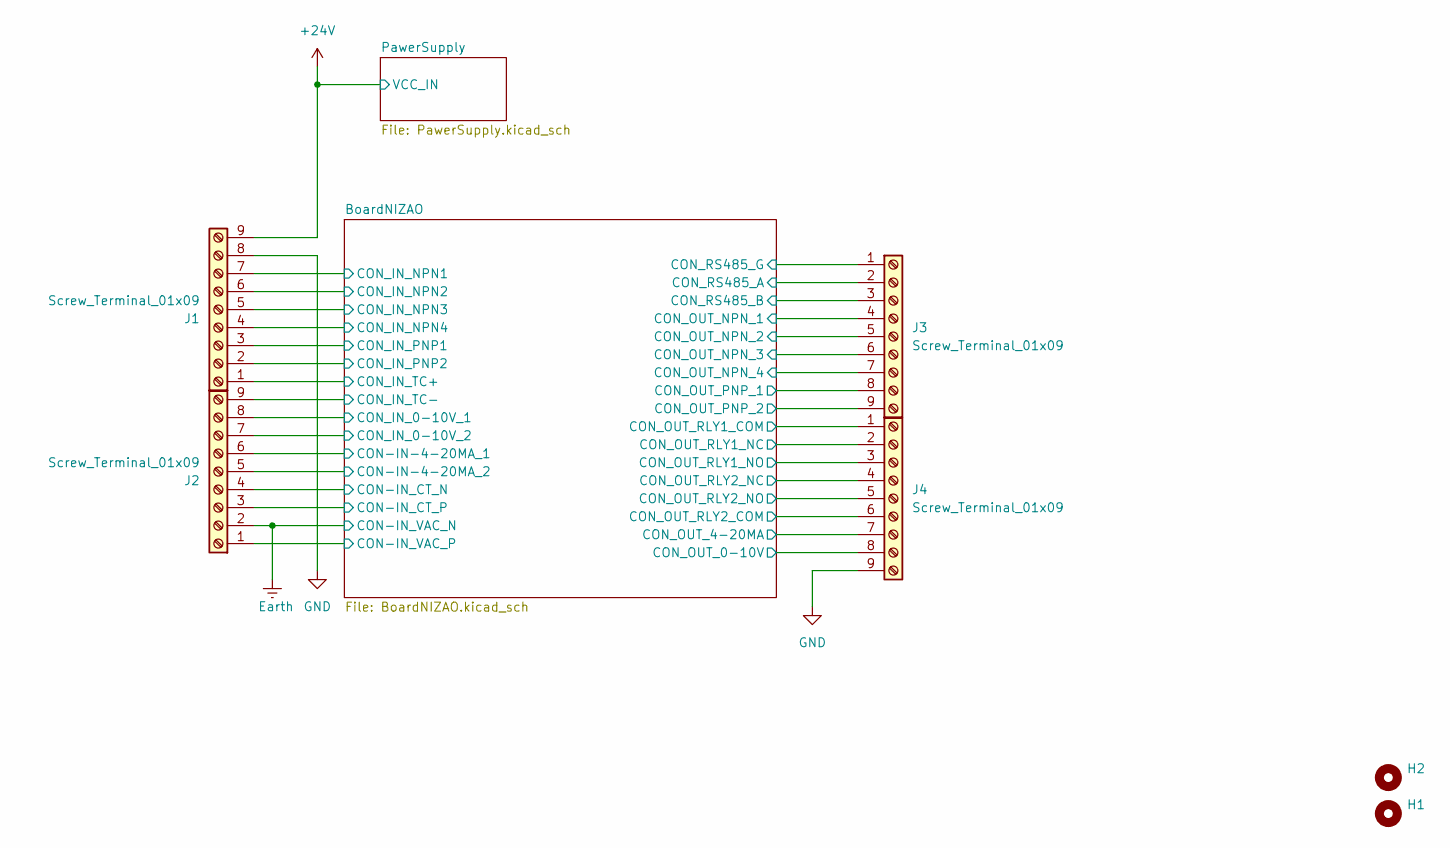
[picture p24: schematic NIZAO.kicad_sch]

Parts:
H1, H2: MountingHole; MountingHole_3.2mm_M3
J1, J2, J3, J4: Screw_Terminal_01x09; TerminalBlock_Phoenix_PT-1,5-9-5.0-H_1x09_P5.00mm_Horizontal

Connections:
+24V: J1.9; also elsewhere on the board
/BoardNIZAO/CON-IN-4-20MA_1: J2.6; also elsewhere on the board
/BoardNIZAO/CON-IN-4-20MA_2: J2.5; also elsewhere on the board
/BoardNIZAO/CON-IN_CT_N: J2.4; also elsewhere on the board
/BoardNIZAO/CON-IN_CT_P: J2.3; also elsewhere on the board
/BoardNIZAO/CON-IN_VAC_P: J2.1; also elsewhere on the board
/BoardNIZAO/CON_IN_0-10V_1: J2.8; also elsewhere on the board
/BoardNIZAO/CON_IN_0-10V_2: J2.7; also elsewhere on the board
/BoardNIZAO/CON_IN_NPN1: J1.7; also elsewhere on the board
/BoardNIZAO/CON_IN_NPN2: J1.6; also elsewhere on the board
/BoardNIZAO/CON_IN_NPN3: J1.5; also elsewhere on the board
/BoardNIZAO/CON_IN_NPN4: J1.4; also elsewhere on the board
/BoardNIZAO/CON_IN_PNP1: J1.3; also elsewhere on the board
/BoardNIZAO/CON_IN_PNP2: J1.2; also elsewhere on the board
/BoardNIZAO/CON_IN_TC+: J1.1; also elsewhere on the board
/BoardNIZAO/CON_IN_TC-: J2.9; also elsewhere on the board
/BoardNIZAO/CON_OUT_0-10V: J4.8; also elsewhere on the board
/BoardNIZAO/CON_OUT_4-20MA: J4.7; also elsewhere on the board
/BoardNIZAO/CON_OUT_NPN_1: J3.4; also elsewhere on the board
/BoardNIZAO/CON_OUT_NPN_2: J3.5; also elsewhere on the board
/BoardNIZAO/CON_OUT_NPN_3: J3.6; also elsewhere on the board
/BoardNIZAO/CON_OUT_NPN_4: J3.7; also elsewhere on the board
/BoardNIZAO/CON_OUT_PNP_1: J3.8; also elsewhere on the board
/BoardNIZAO/CON_OUT_PNP_2: J3.9; also elsewhere on the board
/BoardNIZAO/CON_OUT_RLY1_COM: J4.1; also elsewhere on the board
/BoardNIZAO/CON_OUT_RLY1_NC: J4.2; also elsewhere on the board
/BoardNIZAO/CON_OUT_RLY1_NO: J4.3; also elsewhere on the board
/BoardNIZAO/CON_OUT_RLY2_COM: J4.6; also elsewhere on the board
/BoardNIZAO/CON_OUT_RLY2_NC: J4.4; also elsewhere on the board
/BoardNIZAO/CON_OUT_RLY2_NO: J4.5; also elsewhere on the board
/BoardNIZAO/CON_RS485_A: J3.2; also elsewhere on the board
/BoardNIZAO/CON_RS485_B: J3.3; also elsewhere on the board
/BoardNIZAO/CON_RS485_G: J3.1; also elsewhere on the board
Earth: J2.2; also elsewhere on the board
GND: J1.8, J4.9; also elsewhere on the board

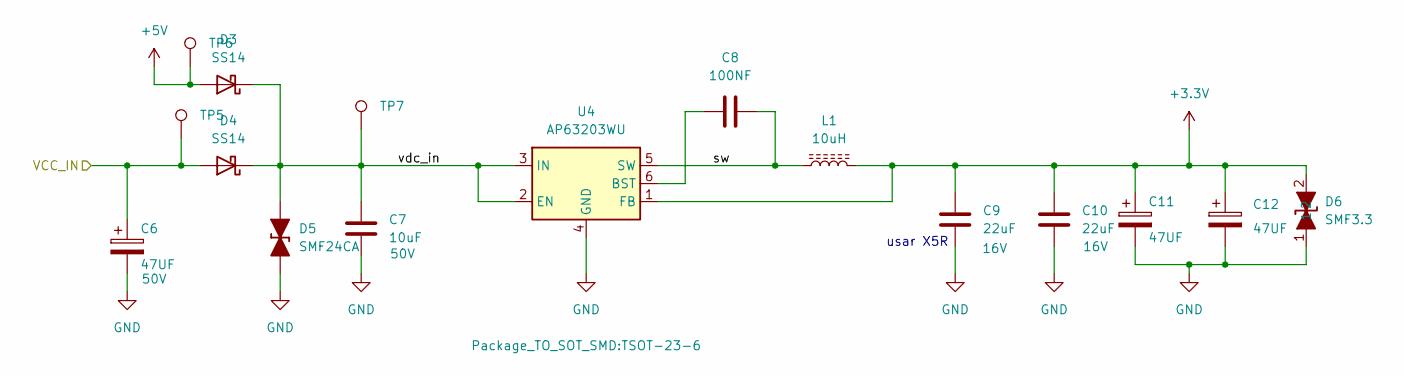
[picture p25: schematic PawerSupply.kicad_sch]

Parts:
C6: 47UF; CP_Elec_6.3x7.7; Part Number C2887275; LCSC Part C2887275
C7: 10uF; C_0805_2012Metric; Part Number GRM21BR61H106KE43L; LCSC Part C440198
C8: 100NF; C_0805_2012Metric; Part Number CC0805KRX7R9BB104; LCSC Part C49678
C9, C10: 22uF; C_0805_2012Metric; Part Number CL21A226MOQNNNE; LCSC Part C98190
C11, C12: 47UF; CP_Elec_6.3x7.7; Part Number UUD1C470MCL1GS
D3, D4: SS14; D_SMA
D5: SMF24CA; D_SOD-123F
D6: SMF3.3; SMF3_3CA_C6165153; Manufacturer Part SMF3.3CA; LCSC C6165153
L1: 10uH; L_APV_APH0630; Part Number SL0630-100M; LCSC Part C22463823
TP5, TP6, TP7: TestPoint_Hole1; TestPoint_THTPad_D1.5mm_Drill0.7mm
U4: AP63203WU; TSOT-23-6

Connections:
+3.3V: C9.1, C10.1, C11.1, C12.1, D6.2, L1.2, U4.1 (FB); also elsewhere on the board
+5V: D3.2 (A), TP6.1 (1_1); also elsewhere on the board
+24V: C6.1, D4.2 (A), TP5.1; also elsewhere on the board
/PawerSupply/sw: C8.2, L1.1, U4.5 (SW)
/PawerSupply/vdc_in: C7.1, D3.1 (K), D4.1 (K), D5.2 (A), TP7.1 (1_1), U4.2 (EN), U4.3 (IN)
GND: C6.2, C7.2, C9.2, C10.2, C11.2, C12.2, D5.1 (K), D6.1, U4.4 (GND); also elsewhere on the board
unnamed: C8.1, U4.6 (BST)

Notes on the sheet:
usar X5R

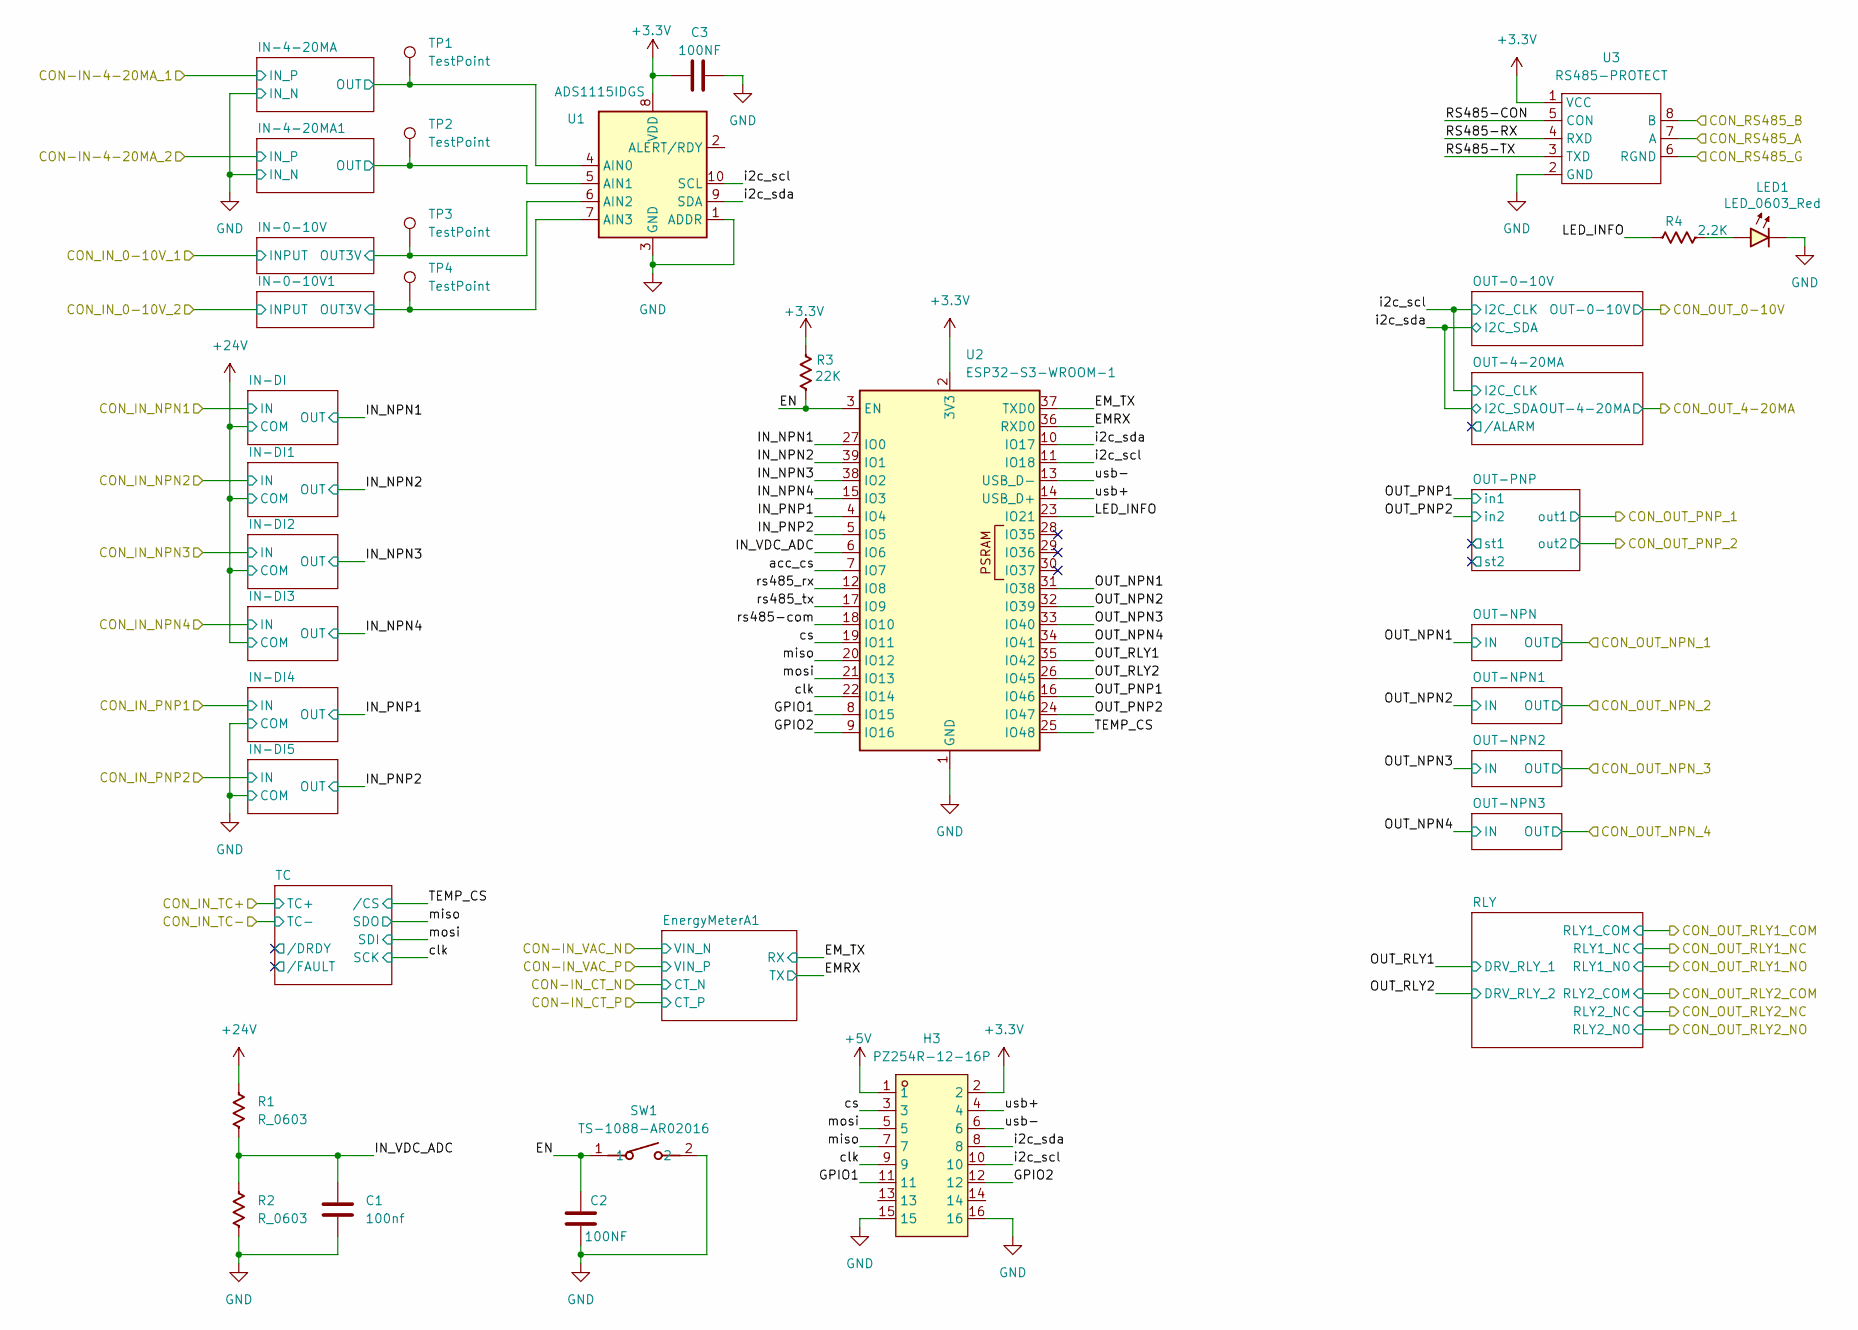
[picture p26: schematic BoardNIZAO.kicad_sch]

Parts:
C1: 100nf; C_0603_1608Metric
C2, C3: 100NF; C_0603_1608Metric
H3: PZ254R-12-16P; HDR-TH_16P-P2.54-H-M-R2-C8-S2.54; LCSC Part C492436
LED1: LED_0603_Red; LED_0603_1608Metric
R1, R2: R_0603; R_0603_1608Metric
R3: 22K; R_0603_1608Metric
R4: 2.2K; R_0603_1608Metric
SW1: TS-1088-AR02016; Manufacturer Part TS-1088-AR02016; LCSC C720477
TP1, TP2, TP3, TP4: TestPoint; TestPoint_THTPad_D1.5mm_Drill0.7mm
U1: ADS1115IDGS; TSSOP-10_3x3mm_P0.5mm
U2: ESP32-S3-WROOM-1; ESP32-S3-WROOM-1U
U3: RS485-PROTECT; RS-485-PROTECT; Part Number RS-485-PROTECT

Connections:
+3.3V: C3.1, H3.2, R3.2, U1.8 (VDD), U2.2 (3V3), U3.1 (VCC); also elsewhere on the board
+5V: H3.1; also elsewhere on the board
+24V: R1.1; also elsewhere on the board
/BoardNIZAO/CON_RS485_A: U3.7 (A); also elsewhere on the board
/BoardNIZAO/CON_RS485_B: U3.8 (B); also elsewhere on the board
/BoardNIZAO/CON_RS485_G: U3.6 (RGND); also elsewhere on the board
/BoardNIZAO/EMRX: U2.36 (RXD0); also elsewhere on the board
/BoardNIZAO/EM_TX: U2.37 (TXD0); also elsewhere on the board
/BoardNIZAO/EN: C2.2, R3.1, SW1.1, U2.3 (EN)
/BoardNIZAO/GPIO1: H3.11, U2.8 (IO15)
/BoardNIZAO/GPIO2: H3.12, U2.9 (IO16)
/BoardNIZAO/IN-0-10V1/OUT3V: TP4.1 (1_1), U1.7 (AIN3); also elsewhere on the board
/BoardNIZAO/IN-0-10V/OUT3V: TP3.1 (1_1), U1.6 (AIN2); also elsewhere on the board
/BoardNIZAO/IN-4-20MA1/OUT: TP2.1 (1_1), U1.5 (AIN1); also elsewhere on the board
/BoardNIZAO/IN-4-20MA/OUT: TP1.1 (1_1), U1.4 (AIN0); also elsewhere on the board
/BoardNIZAO/IN_NPN1: U2.27 (IO0); also elsewhere on the board
/BoardNIZAO/IN_NPN2: U2.39 (IO1); also elsewhere on the board
/BoardNIZAO/IN_NPN3: U2.38 (IO2); also elsewhere on the board
/BoardNIZAO/IN_NPN4: U2.15 (IO3); also elsewhere on the board
/BoardNIZAO/IN_PNP1: U2.4 (IO4); also elsewhere on the board
/BoardNIZAO/IN_PNP2: U2.5 (IO5); also elsewhere on the board
/BoardNIZAO/IN_VDC_ADC: C1.1, R1.2, R2.1, U2.6 (IO6)
/BoardNIZAO/LED_INFO: R4.2, U2.23 (IO21)
/BoardNIZAO/OUT_NPN1: U2.31 (IO38); also elsewhere on the board
/BoardNIZAO/OUT_NPN2: U2.32 (IO39); also elsewhere on the board
/BoardNIZAO/OUT_NPN3: U2.33 (IO40); also elsewhere on the board
/BoardNIZAO/OUT_NPN4: U2.34 (IO41); also elsewhere on the board
/BoardNIZAO/OUT_PNP1: U2.16 (IO46); also elsewhere on the board
/BoardNIZAO/OUT_PNP2: U2.24 (IO47); also elsewhere on the board
/BoardNIZAO/OUT_RLY1: U2.35 (IO42); also elsewhere on the board
/BoardNIZAO/OUT_RLY2: U2.26 (IO45); also elsewhere on the board
/BoardNIZAO/RS485-CON: U3.5 (CON)
/BoardNIZAO/RS485-RX: U3.4 (RXD)
/BoardNIZAO/RS485-TX: U3.3 (TXD)
/BoardNIZAO/TEMP_CS: U2.25 (IO48); also elsewhere on the board
/BoardNIZAO/acc_cs: U2.7 (IO7)
/BoardNIZAO/clk: H3.9, U2.22 (IO14); also elsewhere on the board
/BoardNIZAO/cs: H3.3, U2.19 (IO11)
/BoardNIZAO/i2c_scl: H3.10, U1.10 (SCL), U2.11 (IO18); also elsewhere on the board
/BoardNIZAO/i2c_sda: H3.8, U1.9 (SDA), U2.10 (IO17); also elsewhere on the board
/BoardNIZAO/miso: H3.7, U2.20 (IO12); also elsewhere on the board
/BoardNIZAO/mosi: H3.5, U2.21 (IO13); also elsewhere on the board
/BoardNIZAO/rs485-com: U2.18 (IO10)
/BoardNIZAO/rs485_rx: U2.12 (IO8)
/BoardNIZAO/rs485_tx: U2.17 (IO9)
/BoardNIZAO/usb+: H3.4, U2.14 (USB_D+)
/BoardNIZAO/usb-: H3.6, U2.13 (USB_D-)
GND: C1.2, C2.1, C3.2, H3.15, H3.16, LED1.1 (K), R2.2, SW1.2, U1.1 (ADDR), U1.3 (GND), U2.1 (GND), U2.40 (GND), U2.41 (GND), U3.2 (GND); also elsewhere on the board
unnamed: LED1.2 (A), R4.1

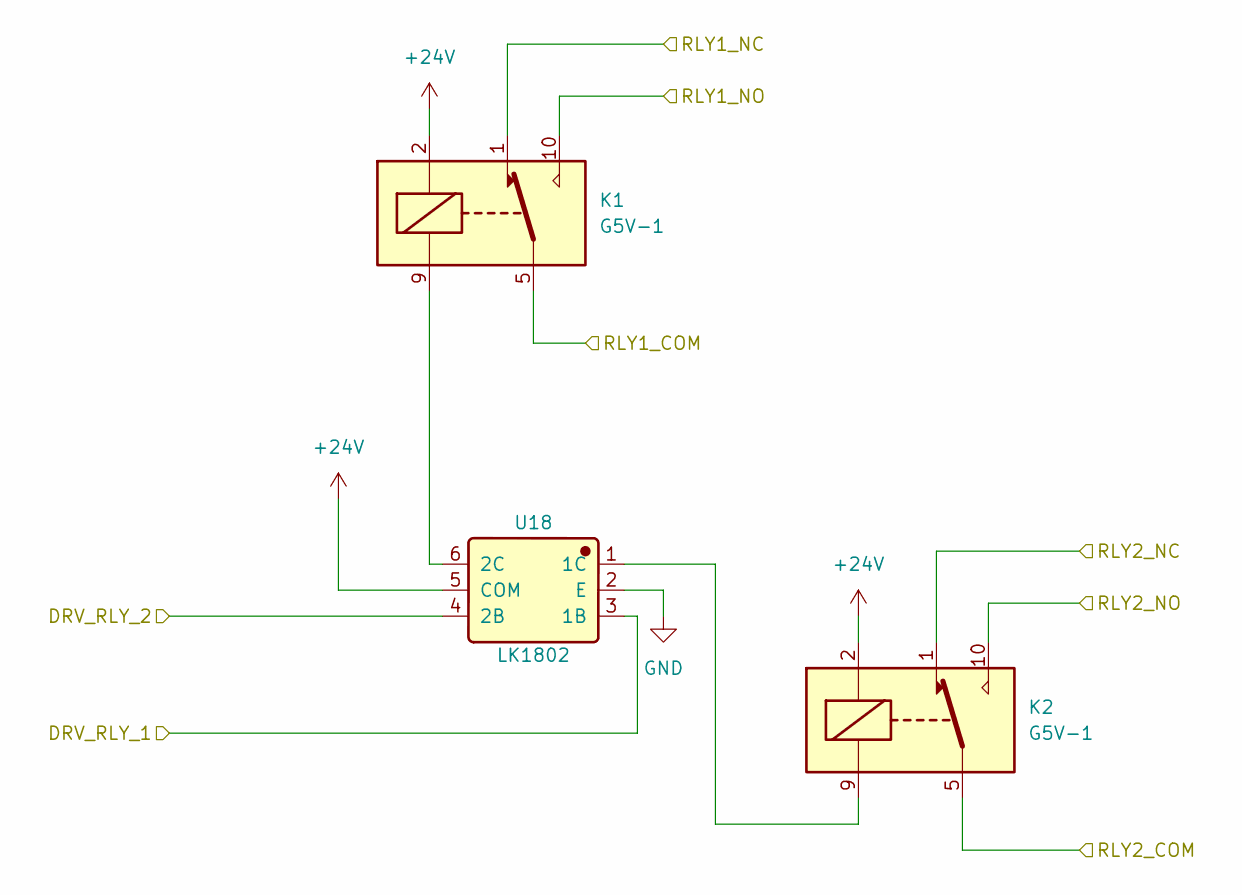
[picture p27: schematic RLY.kicad_sch]

Parts:
K1, K2: G5V-1; Relay_SPDT_Omron_G5V-1
U18: LK1802; Manufacturer Part LK1802; LCSC Part C2984831

Connections:
+24V: K1.2, K2.2, U18.5 (COM); also elsewhere on the board
/BoardNIZAO/CON_OUT_RLY1_COM: K1.5, K1.6; also elsewhere on the board
/BoardNIZAO/CON_OUT_RLY1_NC: K1.1; also elsewhere on the board
/BoardNIZAO/CON_OUT_RLY1_NO: K1.10; also elsewhere on the board
/BoardNIZAO/CON_OUT_RLY2_COM: K2.5, K2.6; also elsewhere on the board
/BoardNIZAO/CON_OUT_RLY2_NC: K2.1; also elsewhere on the board
/BoardNIZAO/CON_OUT_RLY2_NO: K2.10; also elsewhere on the board
/BoardNIZAO/OUT_RLY1: U18.3 (1B); also elsewhere on the board
/BoardNIZAO/OUT_RLY2: U18.4 (2B); also elsewhere on the board
GND: U18.2 (E); also elsewhere on the board
unnamed: K2.9, U18.1 (1C)
unnamed: K1.9, U18.6 (2C)

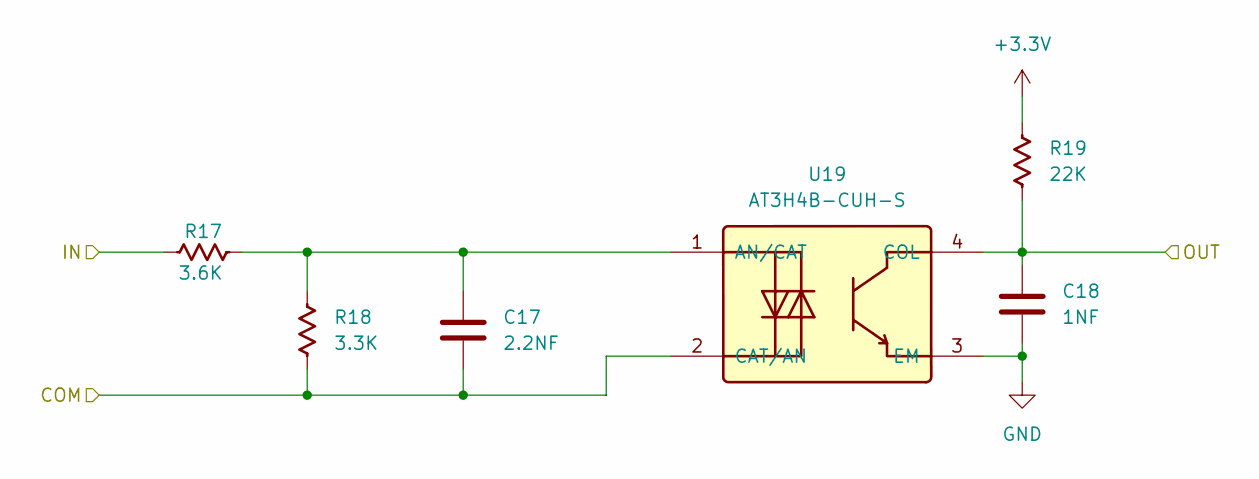
[picture p28: schematic IN-DI.kicad_sch]

Parts:
C17: 2.2NF; C_0603_1608Metric
C18: 1NF; C_0603_1608Metric
R17: 3.6K; R_0603_1608Metric
R18: 3.3K; R_0603_1608Metric
R19: 22K; R_0603_1608Metric
U19: AT3H4B-CUH-S; Manufacturer Part AT3H4B-CuH-S; LCSC Part C20612635

Connections:
+3.3V: R19.2; also elsewhere on the board
+24V: C17.2, R18.1, U19.2 (CAT/AN); also elsewhere on the board
/BoardNIZAO/CON_IN_NPN1: R17.1; also elsewhere on the board
/BoardNIZAO/IN_NPN1: C18.1, R19.1, U19.4 (COL); also elsewhere on the board
GND: C18.2, U19.3 (EM); also elsewhere on the board
unnamed: C17.1, R17.2, R18.2, U19.1 (AN/CAT)

Parts of its further copies:
C19, C21, C23, C25, C27: 2.2NF; C_0603_1608Metric
C20, C22, C24, C26, C28: 1NF; C_0603_1608Metric
R20, R23, R26, R29, R32: 3.6K; R_0603_1608Metric
R21, R24, R27, R30, R33: 3.3K; R_0603_1608Metric
R22, R25, R28, R31, R34: 22K; R_0603_1608Metric
U20, U21, U22, U23, U24: AT3H4B-CUH-S; Manufacturer Part AT3H4B-CuH-S; LCSC Part C20612635

Connections of its further copies:
+3.3V: R22.2, R25.2, R28.2, R31.2, R34.2; also elsewhere on the board
+24V: C19.2, C21.2, C23.2, R21.1, R24.1, R27.1, U20.2 (CAT/AN), U21.2 (CAT/AN), U22.2 (CAT/AN); also elsewhere on the board
/BoardNIZAO/CON_IN_NPN2: R20.1; also elsewhere on the board
/BoardNIZAO/CON_IN_NPN3: R23.1; also elsewhere on the board
/BoardNIZAO/CON_IN_NPN4: R26.1; also elsewhere on the board
/BoardNIZAO/CON_IN_PNP1: R29.1; also elsewhere on the board
/BoardNIZAO/CON_IN_PNP2: R32.1; also elsewhere on the board
/BoardNIZAO/IN_NPN2: C20.1, R22.1, U20.4 (COL); also elsewhere on the board
/BoardNIZAO/IN_NPN3: C22.1, R25.1, U21.4 (COL); also elsewhere on the board
/BoardNIZAO/IN_NPN4: C24.1, R28.1, U22.4 (COL); also elsewhere on the board
/BoardNIZAO/IN_PNP1: C26.1, R31.1, U23.4 (COL); also elsewhere on the board
/BoardNIZAO/IN_PNP2: C28.1, R34.1, U24.4 (COL); also elsewhere on the board
GND: C20.2, C22.2, C24.2, C25.2, C26.2, C27.2, C28.2, R30.1, R33.1, U20.3 (EM), U21.3 (EM), U22.3 (EM), U23.2 (CAT/AN), U23.3 (EM), U24.2 (CAT/AN), U24.3 (EM); also elsewhere on the board
unnamed: C19.1, R20.2, R21.2, U20.1 (AN/CAT)
unnamed: C21.1, R23.2, R24.2, U21.1 (AN/CAT)
unnamed: C23.1, R26.2, R27.2, U22.1 (AN/CAT)
unnamed: C25.1, R29.2, R30.2, U23.1 (AN/CAT)
unnamed: C27.1, R32.2, R33.2, U24.1 (AN/CAT)

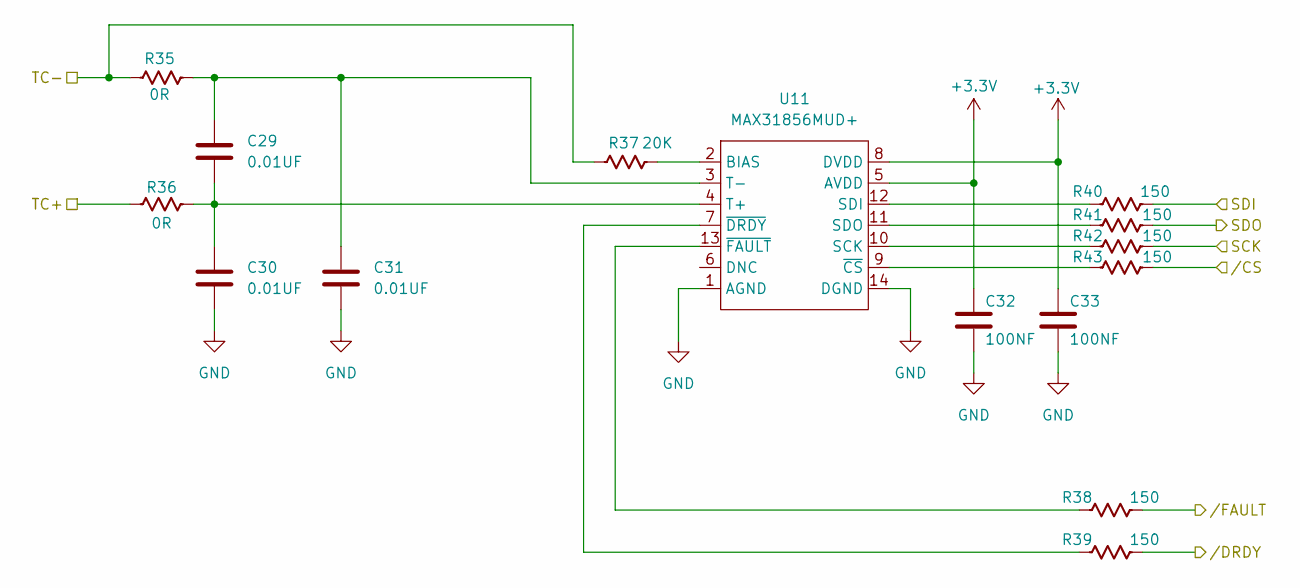
[picture p29: schematic TC.kicad_sch]

Parts:
C29, C30, C31: 0.01UF; C_0603_1608Metric
C32, C33: 100NF; C_0603_1608Metric
R35, R36: 0R; R_0603_1608Metric
R37: 20K; R_0603_1608Metric
R38, R39, R40, R41, R42, R43: 150; R_0603_1608Metric
U11: MAX31856MUD+; MAX31856MUD; LCSC Part C116632

Connections:
+3.3V: C32.1, C33.1, U11.5 (AVDD), U11.8 (DVDD); also elsewhere on the board
/BoardNIZAO/CON_IN_TC+: R36.1; also elsewhere on the board
/BoardNIZAO/CON_IN_TC-: R35.1, R37.1; also elsewhere on the board
/BoardNIZAO/TC//DRDY: R39.2
/BoardNIZAO/TC//FAULT: R38.2
/BoardNIZAO/TEMP_CS: R43.2; also elsewhere on the board
/BoardNIZAO/clk: R42.2; also elsewhere on the board
/BoardNIZAO/miso: R41.2; also elsewhere on the board
/BoardNIZAO/mosi: R40.2; also elsewhere on the board
GND: C30.2, C31.2, C32.2, C33.2, U11.1 (AGND), U11.14 (DGND); also elsewhere on the board
unnamed: R37.2, U11.2 (BIAS)
unnamed: R42.1, U11.10 (SCK)
unnamed: R40.1, U11.12 (SDI)
unnamed: R41.1, U11.11 (SDO)
unnamed: C29.2, C30.1, R36.2, U11.4 (T+)
unnamed: C29.1, C31.1, R35.2, U11.3 (T-)
unnamed: R43.1, U11.9 (~CS)
unnamed: R39.1, U11.7 (~DRDY)
unnamed: R38.1, U11.13 (~FAULT)

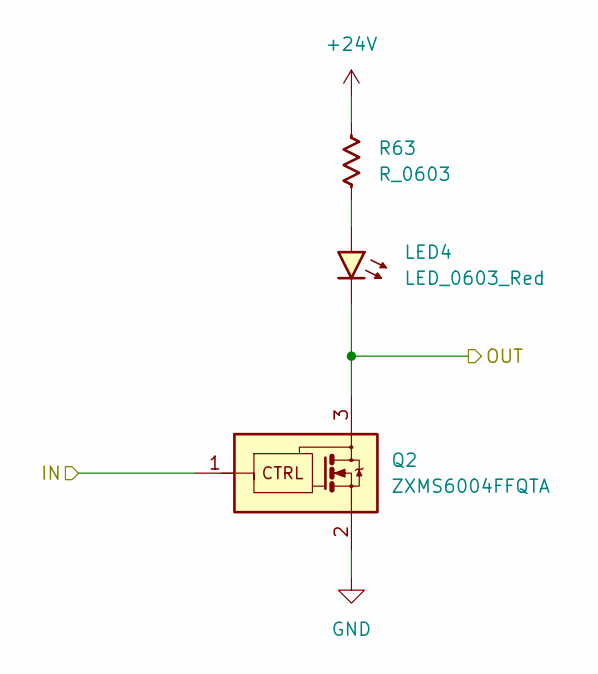
[picture p30: schematic OUT-NPN.kicad_sch]

Parts:
LED4: LED_0603_Red; LED_0603_1608Metric
Q2: ZXMS6004FFQTA; SOT-23-3; Part Number ZXMS6004FFQTA
R63: R_0603; R_0603_1608Metric

Connections:
+24V: R63.1; also elsewhere on the board
/BoardNIZAO/CON_OUT_NPN_1: LED4.1 (K), Q2.3 (D); also elsewhere on the board
/BoardNIZAO/OUT_NPN1: Q2.1 (IN); also elsewhere on the board
GND: Q2.2 (OUT); also elsewhere on the board
unnamed: LED4.2 (A), R63.2

Parts of its further copies:
LED5, LED6, LED7: LED_0603_Red; LED_0603_1608Metric
Q3, Q4, Q5: ZXMS6004FFQTA; SOT-23-3; Part Number ZXMS6004FFQTA
R64, R65, R66: R_0603; R_0603_1608Metric

Connections of its further copies:
+24V: R64.1, R65.1, R66.1; also elsewhere on the board
/BoardNIZAO/CON_OUT_NPN_2: LED5.1 (K), Q3.3 (D); also elsewhere on the board
/BoardNIZAO/CON_OUT_NPN_3: LED6.1 (K), Q4.3 (D); also elsewhere on the board
/BoardNIZAO/CON_OUT_NPN_4: LED7.1 (K), Q5.3 (D); also elsewhere on the board
/BoardNIZAO/OUT_NPN2: Q3.1 (IN); also elsewhere on the board
/BoardNIZAO/OUT_NPN3: Q4.1 (IN); also elsewhere on the board
/BoardNIZAO/OUT_NPN4: Q5.1 (IN); also elsewhere on the board
GND: Q3.2 (OUT), Q4.2 (OUT), Q5.2 (OUT); also elsewhere on the board
unnamed: LED5.2 (A), R64.2
unnamed: LED6.2 (A), R65.2
unnamed: LED7.2 (A), R66.2

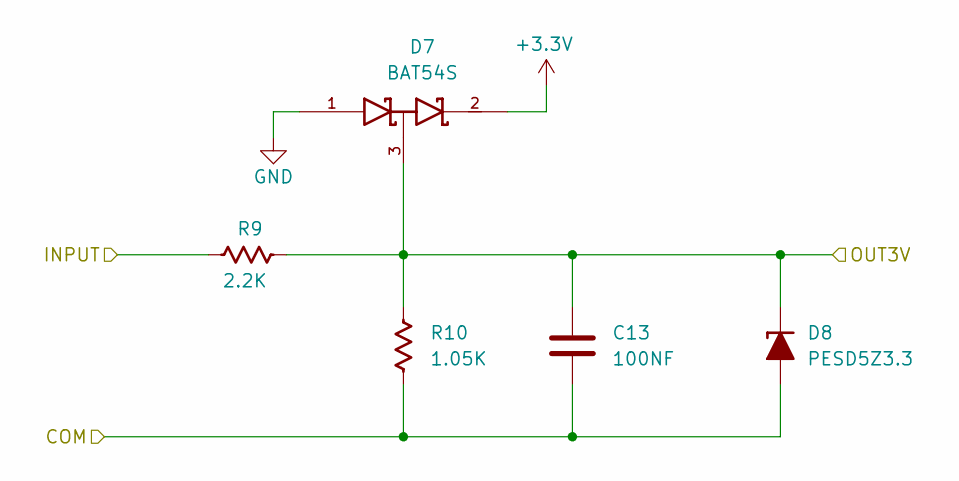
[picture p31: schematic IN-0-10V.kicad_sch]

Parts:
C13: 100NF; C_0603_1608Metric
D7: BAT54S; BAT54S-7-F; Part Number BAT54S-7-F; JLCPCB ID C83574
D8: PESD5Z3.3; D_SOD-523
R9: 2.2K; R_0603_1608Metric
R10: 1.05K; R_0603_1608Metric

Connections:
+3.3V: D7.2 (cathode); also elsewhere on the board
/BoardNIZAO/CON_IN_0-10V_1: R9.1; also elsewhere on the board
/BoardNIZAO/IN-0-10V/COM: C13.2, D8.2 (A), R10.2
/BoardNIZAO/IN-0-10V/OUT3V: C13.1, D7.3 (AK), D8.1 (K), R9.2, R10.1; also elsewhere on the board
GND: D7.1 (Anode); also elsewhere on the board

Parts of its further copies:
C16: 100NF; C_0603_1608Metric
D11: BAT54S; BAT54S-7-F; Part Number BAT54S-7-F; JLCPCB ID C83574
D12: PESD5Z3.3; D_SOD-523
R15: 2.2K; R_0603_1608Metric
R16: 1.05K; R_0603_1608Metric

Connections of its further copies:
+3.3V: D11.2 (cathode); also elsewhere on the board
/BoardNIZAO/CON_IN_0-10V_2: R15.1; also elsewhere on the board
/BoardNIZAO/IN-0-10V1/COM: C16.2, D12.2 (A), R16.2
/BoardNIZAO/IN-0-10V1/OUT3V: C16.1, D11.3 (AK), D12.1 (K), R15.2, R16.1; also elsewhere on the board
GND: D11.1 (Anode); also elsewhere on the board

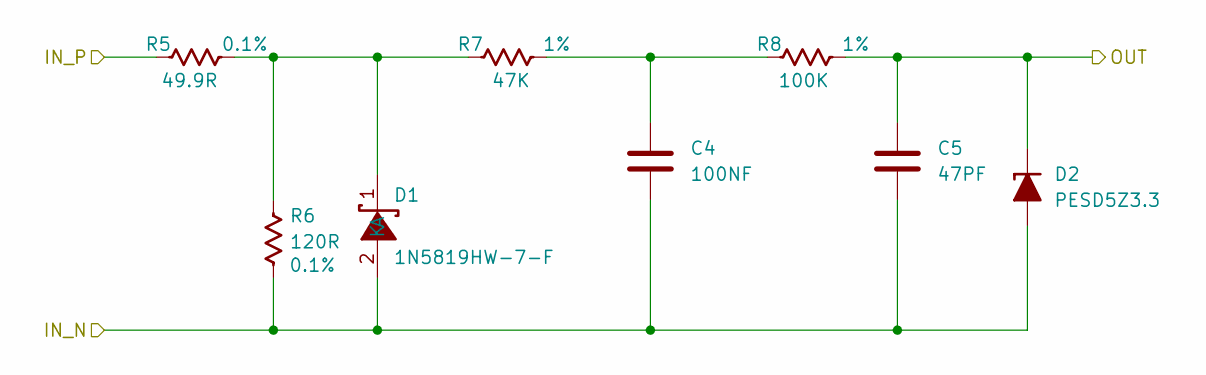
[picture p32: schematic IN-4-20MA.kicad_sch]

Parts:
C4: 100NF; C_0603_1608Metric
C5: 47PF; C_0603_1608Metric
D1: 1N5819HW-7-F; Manufacturer Part 1N5819HW-7-F; LCSC Part C82544
D2: PESD5Z3.3; D_SOD-523
R5: 49.9R; R_0603_1608Metric
R6: 120R; R_0603_1608Metric
R7: 47K; R_0603_1608Metric
R8: 100K; R_0603_1608Metric

Connections:
/BoardNIZAO/CON-IN-4-20MA_1: R5.2; also elsewhere on the board
/BoardNIZAO/IN-4-20MA/OUT: C5.1, D2.1 (K), R8.1; also elsewhere on the board
GND: C4.2, C5.2, D1.2 (A), D2.2 (A), R6.1; also elsewhere on the board
unnamed: C4.1, R7.1, R8.2
unnamed: D1.1 (K), R5.1, R6.2, R7.2

Parts of its further copies:
C14: 100NF; C_0603_1608Metric
C15: 47PF; C_0603_1608Metric
D9: 1N5819HW-7-F; Manufacturer Part 1N5819HW-7-F; LCSC Part C82544
D10: PESD5Z3.3; D_SOD-523
R11: 49.9R; R_0603_1608Metric
R12: 120R; R_0603_1608Metric
R13: 47K; R_0603_1608Metric
R14: 100K; R_0603_1608Metric

Connections of its further copies:
/BoardNIZAO/CON-IN-4-20MA_2: R11.2; also elsewhere on the board
/BoardNIZAO/IN-4-20MA1/OUT: C15.1, D10.1 (K), R14.1; also elsewhere on the board
GND: C14.2, C15.2, D9.2 (A), D10.2 (A), R12.1; also elsewhere on the board
unnamed: C14.1, R13.1, R14.2
unnamed: D9.1 (K), R11.1, R12.2, R13.2

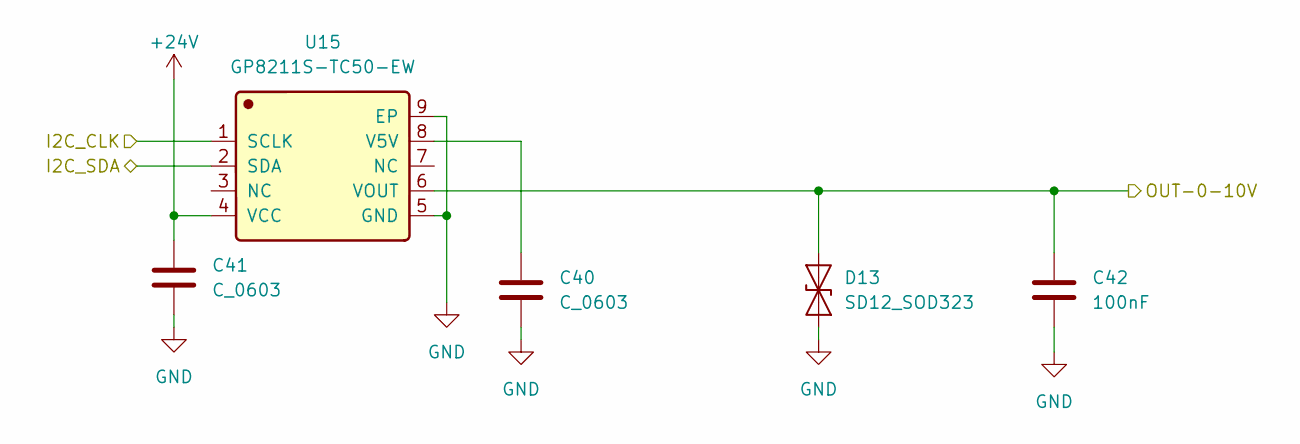
[picture p33: schematic OUT-0-10V.kicad_sch]

Parts:
C40, C41: C_0603; C_0603_1608Metric
C42: 100nF; C_0603_1608Metric
D13: SD12_SOD323; D_SOD-323
U15: GP8211S-TC50-EW; Manufacturer Part GP8211S-TC50-EW; LCSC Part C3152008

Connections:
+24V: C41.1, U15.4 (VCC); also elsewhere on the board
/BoardNIZAO/CON_OUT_0-10V: C42.1, D13.2 (A2), U15.6 (VOUT); also elsewhere on the board
/BoardNIZAO/i2c_scl: U15.1 (SCLK); also elsewhere on the board
/BoardNIZAO/i2c_sda: U15.2 (SDA); also elsewhere on the board
GND: C40.2, C41.2, C42.2, D13.1 (A1), U15.5 (GND), U15.9 (EP); also elsewhere on the board
unnamed: C40.1, U15.8 (V5V)

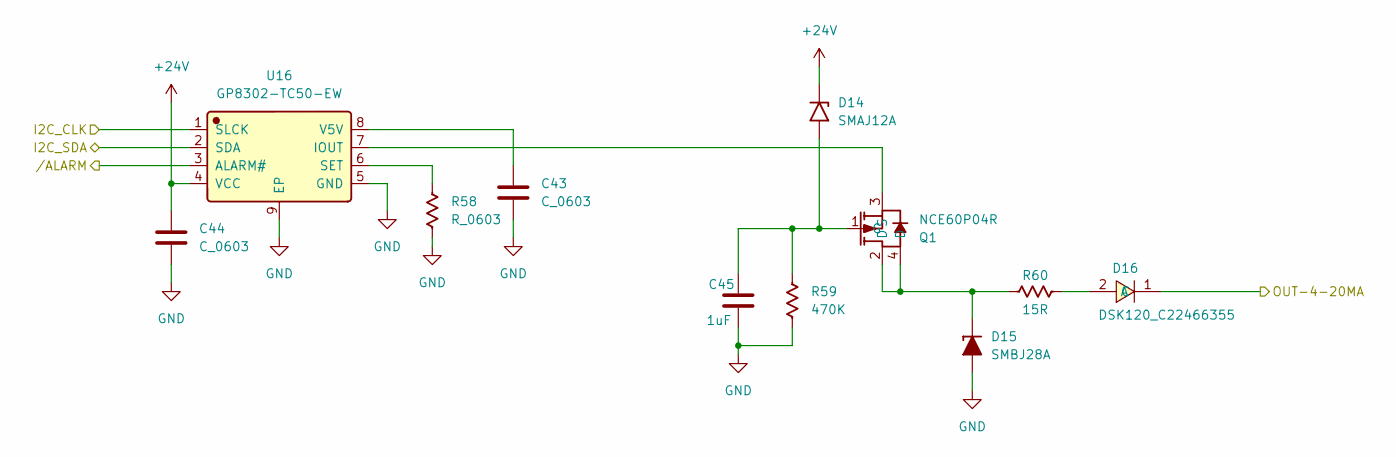
[picture p34: schematic OUT-4-20MA.kicad_sch]

Parts:
C43, C44: C_0603; C_0603_1608Metric
C45: 1uF; C_0603_1608Metric
D14: SMAJ12A; D_SMA
D15: SMBJ28A; D_SMB
D16: DSK120_C22466355; D_SOD-123; LCSC Part C22466355
Q1: NCE60P04R; Manufacturer Part NCE60P04R; LCSC Part C502855
R58: R_0603; R_0603_1608Metric
R59: 470K; R_0603_1608Metric
R60: 15R; R_0805_2012Metric
U16: GP8302-TC50-EW; Manufacturer Part GP8302-TC50-EW; LCSC Part C2856295

Connections:
+24V: C44.1, D14.1 (A1), U16.4 (VCC); also elsewhere on the board
/BoardNIZAO/CON_OUT_4-20MA: D16.1 (C); also elsewhere on the board
/BoardNIZAO/OUT-4-20MA//ALARM: U16.3 (ALARM#)
/BoardNIZAO/i2c_scl: U16.1 (SLCK); also elsewhere on the board
/BoardNIZAO/i2c_sda: U16.2 (SDA); also elsewhere on the board
GND: C43.2, C44.2, C45.2, D15.2 (A), R58.2, R59.2, U16.5 (GND), U16.9 (EP); also elsewhere on the board
unnamed: C45.1, D14.2 (A2), Q1.1 (G), R59.1
unnamed: D15.1 (K), Q1.2 (D), Q1.4 (D), R60.1
unnamed: D16.2 (A), R60.2
unnamed: Q1.3 (S), U16.7 (IOUT)
unnamed: R58.1, U16.6 (SET)
unnamed: C43.1, U16.8 (V5V)

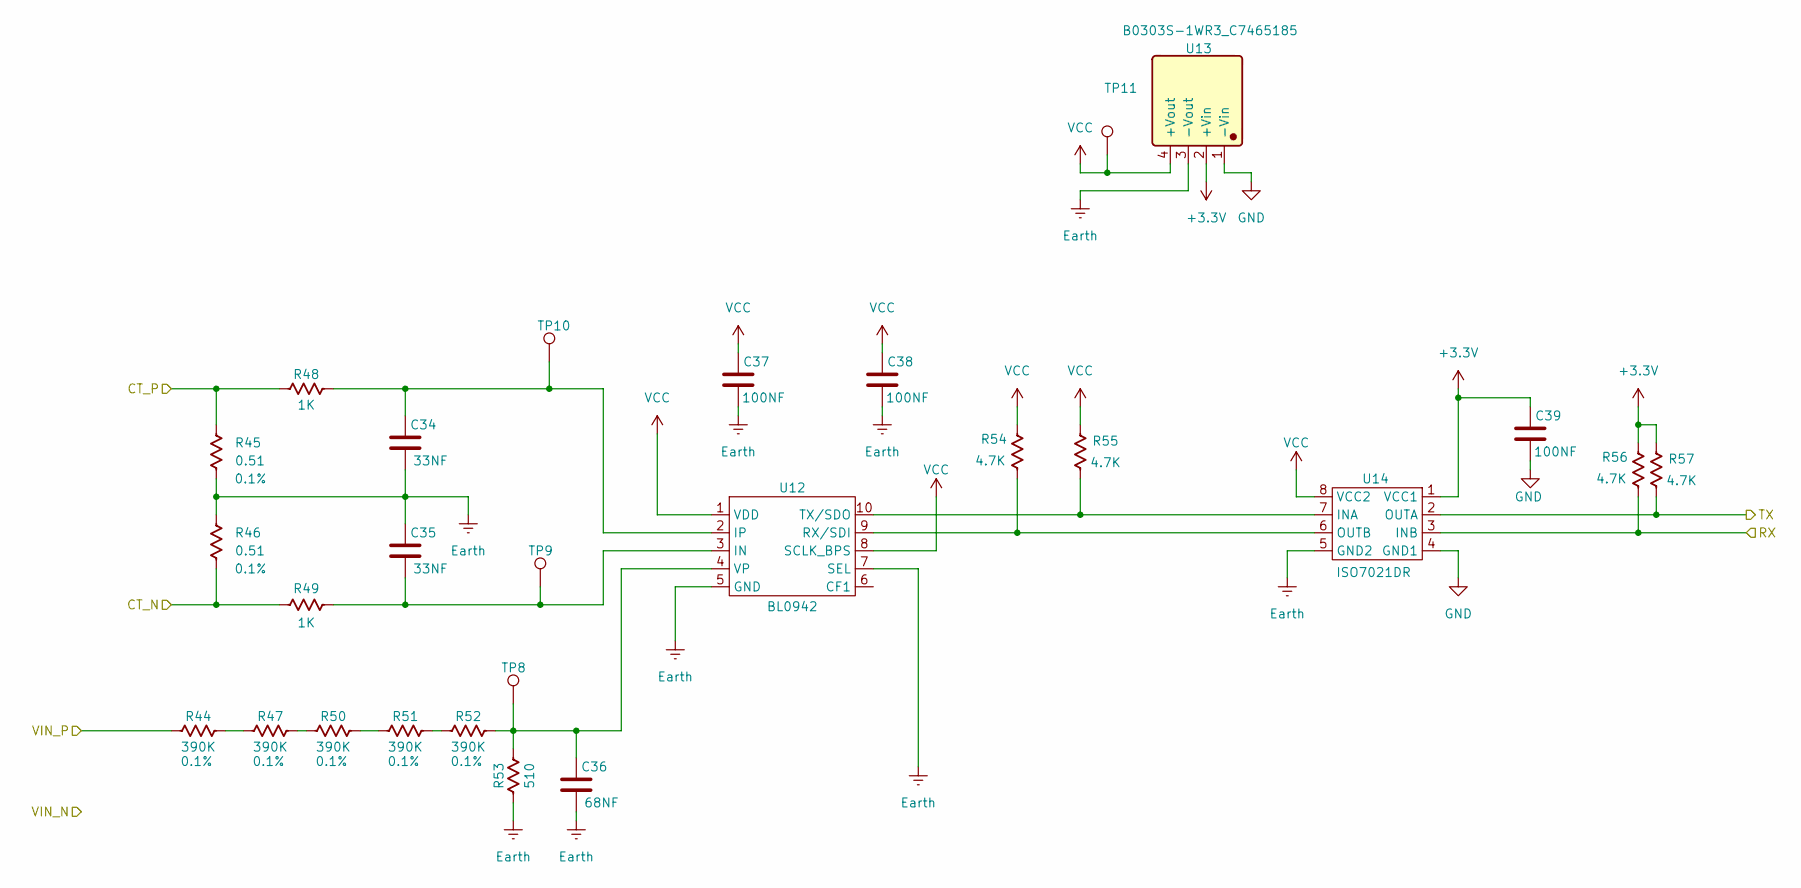
[picture p35: schematic EnergyMeterA1.kicad_sch]

Parts:
C34, C35: 33NF; C_0603_1608Metric
C36: 68NF; C_0603_1608Metric
C37, C38, C39: 100NF; C_0603_1608Metric
R44, R47, R50, R51, R52: 390K; R_0603_1608Metric
R45, R46: 0.51; R_0805_2012Metric
R48, R49: 1K; R_0603_1608Metric
R53: 510; R_0603_1608Metric
R54, R55, R56, R57: 4.7K; R_0603_1608Metric
TP8, TP9, TP10, TP11: TestPoint_Hole1; TestPoint_THTPad_D1.5mm_Drill0.7mm
U12: BL0942; LCSC Part C2837510
U13: B0303S-1WR3_C7465185; Manufacturer Part B0303S-1WR3; LCSC Part C7465185
U14: ISO7021DR; LCSC Part C2867957

Connections:
+3.3V: C39.2, R56.2, R57.2, U13.2 (+Vin), U14.1 (VCC1); also elsewhere on the board
/BoardNIZAO/CON-IN_CT_N: R46.2, R49.1; also elsewhere on the board
/BoardNIZAO/CON-IN_CT_P: R45.1, R48.1; also elsewhere on the board
/BoardNIZAO/CON-IN_VAC_P: R44.1; also elsewhere on the board
/BoardNIZAO/EMRX: R57.1, U14.2 (OUTA); also elsewhere on the board
/BoardNIZAO/EM_TX: R56.1, U14.3 (INB); also elsewhere on the board
Earth: C34.1, C35.2, C36.1, C37.1, C38.1, R45.2, R46.1, R53.1, U12.5 (GND), U12.7 (SEL), U13.3 (-Vout), U14.5 (GND2); also elsewhere on the board
GND: C39.1, U13.1 (-Vin), U14.4 (GND1); also elsewhere on the board
unnamed: R44.2, R47.1
unnamed: R47.2, R50.1
unnamed: R50.2, R51.1
unnamed: R51.2, R52.1
unnamed: C35.1, R49.2, TP9.1 (1_1), U12.3 (IN)
unnamed: C34.2, R48.2, TP10.1 (1_1), U12.2 (IP)
unnamed: R54.1, U12.9 (RX/SDI), U14.6 (OUTB)
unnamed: R55.1, U12.10 (TX/SDO), U14.7 (INA)
unnamed: C36.2, R52.2, R53.2, TP8.1 (1_1), U12.4 (VP)
VCC: C37.2, C38.2, R54.2, R55.2, TP11.1 (1_1), U12.1 (VDD), U12.8 (SCLK_BPS), U13.4 (+Vout), U14.8 (VCC2)

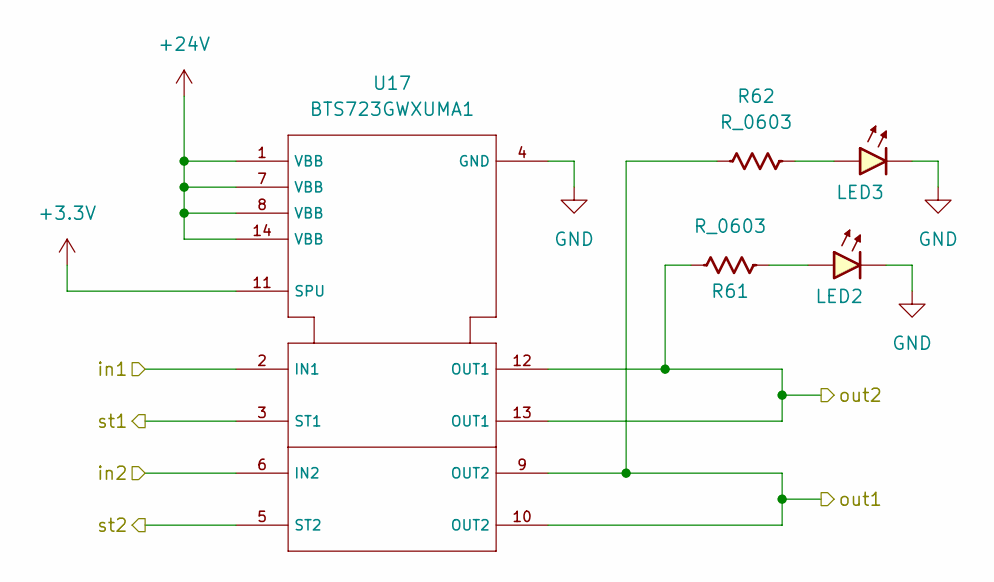
[picture p36: schematic OUT-PNP.kicad_sch]

Parts:
LED2, LED3: LED_0603_Red; LED_0603_1608Metric
R61, R62: R_0603; R_0603_1608Metric
U17: BTS723GWXUMA1; LCSC Part C67625

Connections:
+3.3V: U17.11 (SPU); also elsewhere on the board
+24V: U17.1 (VBB), U17.7 (VBB), U17.8 (VBB), U17.14 (VBB); also elsewhere on the board
/BoardNIZAO/CON_OUT_PNP_1: R62.1, U17.9 (OUT2), U17.10 (OUT2); also elsewhere on the board
/BoardNIZAO/CON_OUT_PNP_2: R61.1, U17.12 (OUT1), U17.13 (OUT1); also elsewhere on the board
/BoardNIZAO/OUT-PNP/st1: U17.3 (ST1)
/BoardNIZAO/OUT-PNP/st2: U17.5 (ST2)
/BoardNIZAO/OUT_PNP1: U17.2 (IN1); also elsewhere on the board
/BoardNIZAO/OUT_PNP2: U17.6 (IN2); also elsewhere on the board
GND: LED2.1 (K), LED3.1 (K), U17.4 (GND); also elsewhere on the board
unnamed: LED2.2 (A), R61.2
unnamed: LED3.2 (A), R62.2
