ronand68/Ronand_Peralta_Electiva_2026_C1/NIZAO/NIZAO.kicad_pcb

## KiCad design NIZAO/NIZAO.kicad_pcb (continued)

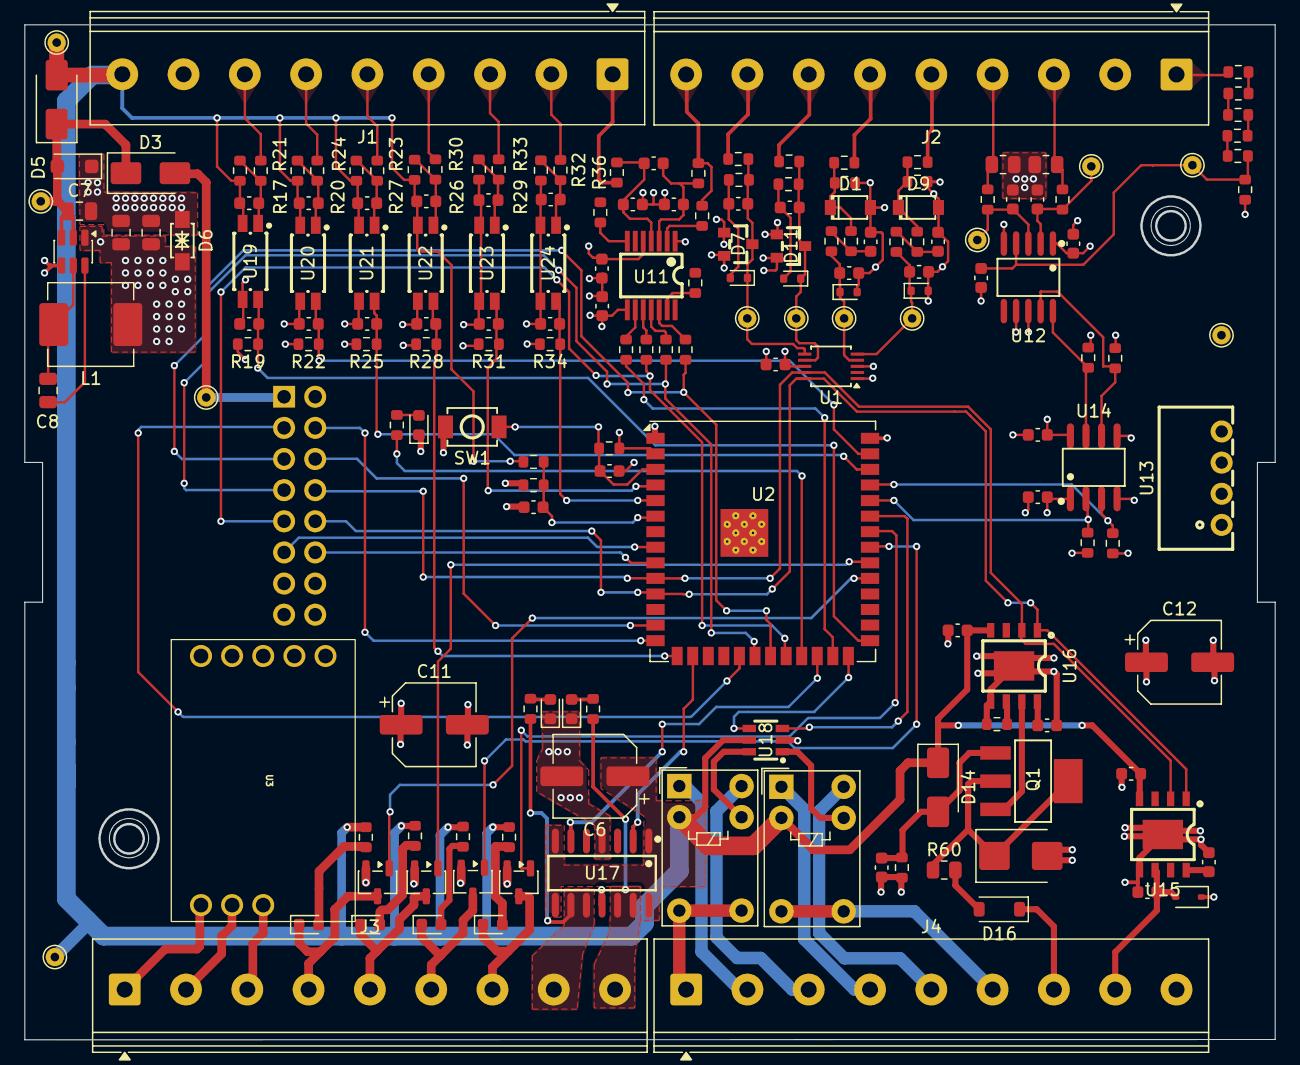
[picture p37: board NIZAO.kicad_pcb from above]

Board: 4 copper layers, 102.0 x 82.8 mm, 180 parts (0 on the bottom side), 121 nets.

Other parts of the board:
TP5#2: TestPoint_Hole1; TestPoint_THTPad_D1.5mm_Drill0.7mm

Their connections:
+24V: TP5#2.1 (1_1); also elsewhere on the board
