ronand68/Ronand_Peralta_Electiva_2026_C1/tarea 4/PLC4UNI_MEZZANINE_PCB1/PLC4UNI_MEZZANINE_PCB1.kicad_pcb

## KiCad design tarea 4/PLC4UNI_MEZZANINE_PCB1/PLC4UNI_MEZZANINE_PCB1.kicad_pcb (2026-04-02)

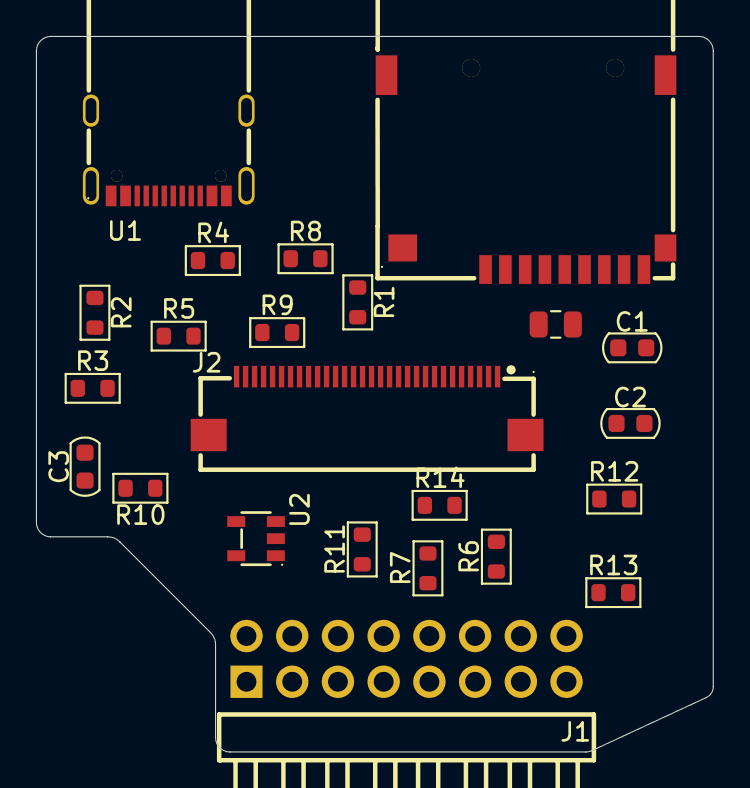
[picture p38: board PLC4UNI_MEZZANINE_PCB1.kicad_pcb from above]

Board: 2 copper layers, 37.6 x 39.8 mm, 23 parts (0 on the bottom side), 26 nets, no tracks yet.

Parts:
C1: 47uF; C_0603_1608Metric
C2: 100nF; C_0603_1608Metric
C3: 10uF; C_0603_1608Metric
Card1: TF-115; TF-SMD_TF-115
J1: PZ254R-12-16P; HDR-TH_16P-P2.54-H-M-R2-C8-S2.54
J2: FPC-05FB-30PH20; FPC-SMD_30P-P0.50_FPC-05FB-30PH20
L1: 600 Ohm; C_0805_2012Metric
R1, R2: 5.1k; R_0603_1608Metric
R3, R5: 2.2K; R_0603_1608Metric
R4, R8, R9, R12, R13, R14: 10K; R_0603_1608Metric
R6: 10R; R_0603_1608Metric
R7: 220R; R_0603_1608Metric
R10: 6.8K; R_0603_1608Metric
R11: 300; R_0603_1608Metric
U1: MC-121-L119; USB-C-SMD_HANBO_MC-121-L119
U2: MT9700-N; SOT-23-5_L2.9-W1.6-P0.95-LS2.9-BL

Connections:
+3.3V: C3.1, J1.2, L1.2, R3.1, R4.1, R5.1, R8.1, R9.1, R12.1, R13.1, R14.1, U2.5 (VIN)
+5V: J1.1, U1.A4B9 (VBUS), U1.B4A9 (VBUS)
/I2C_SCK: J1.10, J2.26
/I2C_SDA: J1.8, J2.27
/IM2: J2.3, R12.2, R13.2
/LCD_CS: J1.13, J2.6
/LCD_EN: J1.12, U2.4 (EN)
/LED+: J2.20, R11.2
/RESET: J1.11, J2.5, J2.29, R14.2
/SD_CS: Card1.2 (CD/DAT3), J1.3, R9.2
/SPI_CLK: J1.9, J2.7, R6.1
/SPI_MISO: J1.7, J2.19, R5.2, R7.1
/SPI_MOSI: Card1.3 (CMD), J1.5, J2.10, R3.2
/TP_INT: J1.14, J2.28
/USB+: J1.4, U1.A6 (DP1), U1.B6 (DP2)
/USB-: J1.6, U1.A7 (DN1), U1.B7 (DN2)
GND: C1.2, C2.2, C3.2, Card1.6 (VSS), Card1.10 (SHELL), Card1.11 (SHELL), Card1.12 (SHELL), Card1.13 (SHELL), J1.15, J1.16, J2.1, J2.21, J2.22, J2.23, J2.24, J2.30, J2.31, J2.32, R1.2, R2.2, R10.2, U1.13 (EH), U1.A1B12 (GND), U1.B1A12 (GND), U2.2 (GND)
unnamed: Card1.5 (CLK), R6.2
unnamed: Card1.7 (DAT0), R7.2
unnamed: Card1.8 (DAT1), R4.2
unnamed: Card1.1 (DAT2), R8.2
unnamed: C1.1, C2.1, Card1.4 (VDD), L1.1
unnamed: R1.1, U1.A5 (CC1)
unnamed: R2.1, U1.B5 (CC2)
unnamed: R10.1, U2.3 (SET)
VDD: J2.2, J2.25, R11.1, U2.1 (VOUT)
