ronand68/Ronand_Peralta_Electiva_2026_C1/(commit log)

2026-01-16 cambio de nombre del archivo1.txt
2026-01-16 Devolviendo el nombre del archivo
2026-02-04 Subo tareas 1, 2 y 3
    [Base Del Case Plástico.FCStd, NIZAO.kicad_pcb, NIZAO.kicad_sch, Tapa Del Case Plástico.FCStd]
2026-02-05 Actualizo tarea 3
    [BoardNIZAO.kicad_sch, NIZAO.kicad_sch, PawerSupply.kicad_sch]
2026-03-02 Modificado tarea 2, tarea 3, y el documento de la tarea 1
    [Base Del Case Plástico.FCStd, Tapa Del Case Plástico.FCStd]
2026-03-02 cambiando nombre del case de plastico
2026-03-10 Actualizan y creando tarea 4
    [Base Del Case Plastico.dxf, Base Del Case Plastico_F.dxf, BoardNIZAO.kicad_sch, EnergyMeterA1.kicad_sch, IN-0-10V.kicad_sch, IN-4-20MA.kicad_sch, IN-DI.kicad_sch, NIZAO.kicad_pcb]
2026-04-01 Actualiza el mezzanine, eliminar assembly de prueba y actualizar essembly
    [Base Del Case Plastico.FCStd, BoardNIZAO.kicad_sch, NIZAO.FCStd, NIZAO.kicad_pcb, NIZAO.step, NIZAO_3D.FCStd, NIZAO_Assembly.FCStd, NIZAO_Assembly.V1.1.FCStd]
2026-04-02 actualizar Mezzanine y Assembly
    [NIZAO_Assembly.V1.1.FCStd, PLC4UNI_MEZZANINE_PCB1.2.FCStd, PLC4UNI_MEZZANINE_PCB1.FCStd, PLC4UNI_MEZZANINE_PCB1.kicad_pcb]
2026-04-04 Colocandos los 3d de los componetes en la placa NIZAO
    [BoardNIZAO.kicad_sch, EnergyMeterA1.kicad_sch, IN-0-10V.kicad_sch, IN-4-20MA.kicad_sch, IN-DI.kicad_sch, NIZAO.kicad_pcb, NIZAO.kicad_sch, NIZAO_Assembly.V1.1.FCStd]
2026-04-16 ACtualizandos las medidad del case de plastico y NIZAO
    [Base Del Case Plástico.V1.01.FCStd, BoardNIZAO.kicad_sch, NIZAO.kicad_pcb, Tapa Del Case Plástico.V1.01.FCStd]
2026-04-20 Agregado tarea 5
    [Base Del Case Plástico.V1.01.FCStd, Tapa Del Case Plástico.V1.01.FCStd]
